bobc/RAMPS-FD/RAMPS-FD/Docs/RAMPS-FD.png

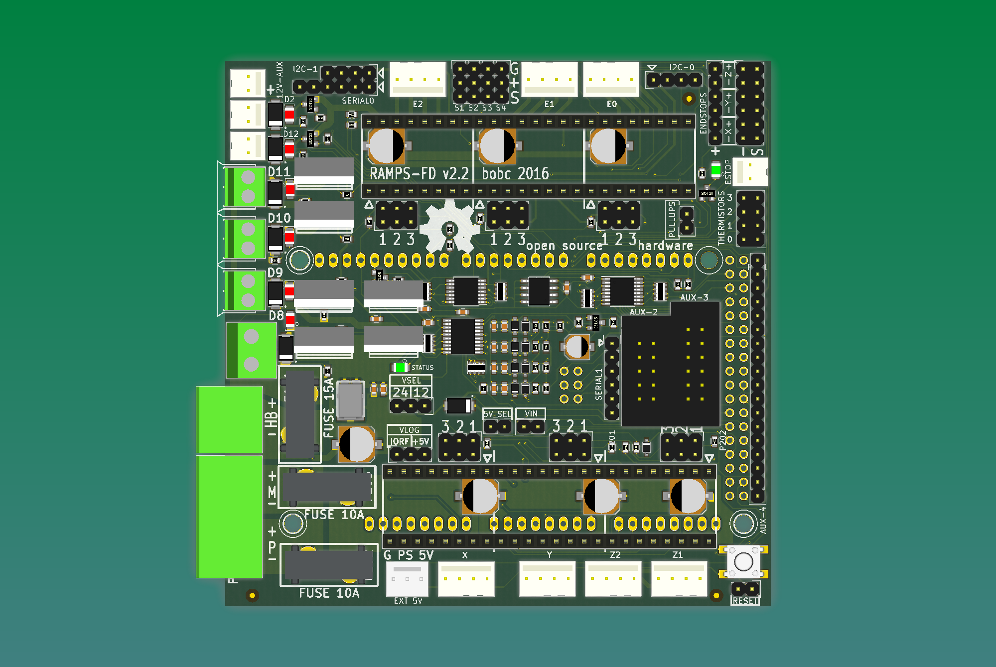
RAMPS-FD/Docs/RAMPS-FD.png
