bobc/RAMPS-FD/README.md

# RAMPS-FD

RAMPS for Due.

THIS IS THE DEVELOPMENT BRANCH.

Design files in the development branch are untested and not ready for manufacturing.

Status
-------

Nothing is ready for release yet!
