bobc/RAMPS-FD/RAMPS-FD/RAMPS-FD_bom_Itead.xlsx

Ref | Value | Footprint | Manf | MPN | Quantity | Digi-Key/Sku
C1,C2,C3,C4,C102,C207,C305,C502,C503,C504,C505,C601 | 100n | C_0603 | Kemet | C0603C104K3RACTU | 12 | 399-1281-6-ND
C101,C201,C202,C203,C204,C205,C206 | 100u; 35V | c_elec_6.3x7.7 | Nichicon | UCD1V101MCL6GS | 7 | 493-6420-1-ND
C301,C302,C303,C501 | 10u | C_0603 | Murata | GRM188R60J106ME47D | 4 | 490-3896-1-ND
C1001 | 10u | c_elec_4x5.3 | Kemet | EDK106M016A9BAA | 1 | 399-6664-1-ND
D1,D101 | LED GREEN | LED-0805_GREEN | Avago | HSMG-C170 | 2 | 516-1434-6-ND
D102 | V10P10 | TO277A_RMC | Vishay | V10P45S-M3/86A | 1 | V10P45S-M3/86A-ND
D103,D401,D402,D403,D404,D903,D904 | ES1F | DO-214AC | TaiwanSemi | ES1F | 7 | ES1FDKR-ND
D201,D202,D203,D204,D901,D902 | LED RED | LED-0805_RED | Avago | HSMH-C170 | 6 | 516-1427-1-ND
D301,D1001,D1002,D1003,D1004,D1005,D1006,D1007,D1008 | 1N4148 | SOD323 | Fairchild | 1N4148WS | 9 | 1N4148WSFSCT-ND
F101,F102,F103 |  | FUSE-MINI-AUTO | LittelFuse | 01530008Z | 3 | F065-ND
JP1,JP201,JP801,P102 |  | Pin_Header_Straight_1x02 | AmphenolFCI | 68001-402HLF | 4 | 609-3507-ND
JP101,JP102,K201,K202,K203,K204 |  | Pin_Header_Straight_1x03 | AmphenolFCI | 68001-403HLF | 6 | 609-3471-ND
L1 | Ferrite Bead | R_0603 | TDK | MMZ1608B601CTAH0 | 1 | 445-2166-1-ND
P1,P216,P801 |  | Pin_Header_Straight_1x06 | AmphenolFCI | 68001-406HLF | 3 | 609-3284-ND
P2,P211 |  | Pin_Header_Straight_1x04 | AmphenolFCI | 68001-404HLF | 2 | 609-3404-ND
P3,P204,P205,P206,P210,P212,P217 |  | CONN_KK_2.54_4W | Molex | 0022232041 | 7 | WM4202-ND
P101 |  | mstba_2,5%2f2-g-5,08 | AmphenolFCI | 20020110-H021A01LF | 1 | 609-3907-ND
P105,P302,P901,P902 |  | CONN_KK_2.54_2W | Molex | 0022232021 | 4 | WM4200-ND
P108 |  | mstba_2,5%2f4-g-5,08 | AmphenolFCI | 20020110-H041A01LF | 1 | 609-3909-ND
P201,P202,P203,P207,P208,P209 |  | Pin_Header_Straight_2x03 | AmphenolFCI | 67996-406HLF | 6 | 609-3218-ND
P213 |  | Pin_Header_Straight_1x18 | Sullins | PREC018SAAN-RC | 1 | S1012EC-18-ND
P214 |  | PIN_ARRAY_5x2_RMC | AmphenolFCI | 67996-410HLF | 1 | 609-3392-ND
P215,P802 |  | PIN_ARRAY_6x2_RMC | AmphenolFCI | 67996-412HLF | 2 | 609-3219-ND
P218,P403,P405 |  | RMC-pt_1,5-2-3,5-h | AmphenolFCI | 20020110-C021A01LF | 3 | 20020110-C021A01LF-ND
P219 |  | CONN_KK_2.54_3W | Molex | 0022232031 | 1 | WM4201-ND
P301 |  | Pin_Header_Straight_2x04 | AmphenolFCI | 67996-408HLF | 1 | 609-3391-ND
P404 |  | mors_2p | PhoenixContact | 1711725 | 1 | 277-1027-ND
Q1,Q101,Q901,Q902 | DMN2075 | SOT23GDS | DiodesZetex | DMN2075U-7 | 4 | DMN2075U-7DIDKR-ND
Q201,Q202,Q203,Q206 | IRLB8743PBF | TO-220AB_IRF2804_RMC | Infineon | IRLB8743PBF | 4 | IRLB8743PBF-ND
R1,R2,R211,R212 | NF | R_0603 |  |  | 4
R3,R101 | 330R | R_0603 | Vishay | CRCW0603330RFKEA | 2 | 541-330HDKR-ND
R201,R202,R203,R207,R208,R210,R304 | 100k | R_0603 | Vishay | CRCW0603100KFKEA | 7 | 541-100KHDKR-ND
R219,R220,R221,R222,R301,R302,R303,R501,R905,R906,R1004 | 1k | R_0603 | Vishay | CRCW06031K00FKEA | 11 | 541-1.00KHDKR-ND
R305,R502,R503,R504,R505 | 4k7 | R_0603 | Vishay | CRCW06034K70FKEA | 5 | 541-4.70KHCT-ND
R401,R402 | 10k | R_0603 | Vishay | CRCW060310K0FKEA | 2 | 541-10.0KHDKR-ND
R701,R702,R703,R704,R901,R902 | 220R | R_0603 | Vishay | CRCW0603220RFKEA | 6 | 541-220HDKR-ND
R1002 | 6k8 | R_0603 | Vishay | CRCW06036K80FKEA | 1 | 541-6.80KHCT-ND
R1003 | 1k8 | R_0603 | Vishay | CRCW06031K80FKEA | 1 | 541-1.80KHCT-ND
RP1,RP2,RP3,RP401,RP801,RP802 | 10k | R_Cat16-4 | Bourns | CAT16-103J4LF | 6 | CAT16-103J4LFCT-ND
 |  |  |  |  | 1
SW101 | Switch | SW_6x6_MULTI | Wurth | 430156070726 | 1 | 430156070726-ND
U1 | 74ACT125 | TSSOP-14_4.4x5mm_Pitch0.65mm | ONSemi | MC74HCT125ADTR2G | 1 | MC74HCT125ADTR2GOSCT-ND
U2 | 74ACT244 | TSSOP-20_4.4x6.5mm_Pitch0.65mm | NXP | 74HCT244PW,112 | 1 | 568-7845-5-ND
U3 | LM7812 | LM78XXV | Fairchild | LM7812ACT | 1 | LM7812ACT-ND
U4 | L7805CV-DG | LM78XXV | STMicro | L7805CV-DG | 1 | 497-12404-ND
U201,U202,U203,U204,U205,U206 |  | POLOLU | Sullins | PPTC081LFBN-RC | 12 | S7006-ND
U601 | 24C512 | SO8E | STMicro | M24512-RMN6TP | 1 | 497-6350-6-ND
U801 | 4050_RMC | TSSOP-16_4.4x5mm_Pitch0.65mm | NXP | 74HC4050PW,118 | 1 | 568-7640-1-ND
U1001 | TL431_SOT23_RMC | SOT23 | STMicro | TL431AIL3T | 1 | 497-11295-6-ND
