bobc/RAMPS-FD/(threads)

Thread 1 (2017-02-03):

LM7812 gets very hot

fullTalgoRythm, 2017-02-03:
When running @24v with JP102 -VSEL pins 1-2 selected I found that the 7812 is getting very hot. I could actually smell it even with a fan running. I believe this would be a fairly typical problem when trying to drop 12v over a linear regulator like this one. I know there are a number of workarounds and personally I replaced mine with a cheap buck converter (LM2596). I can see it is still spec'd so I thought maybe you could investigate some alternatives. Myself I wouldn't mind a separate  input for board power / hotend & fans and then just supply my own power (I did briefly feed 12v in via pin 2 of JP102 but it was a messy solution). It's probably not what most others would want but would make a nice option.

fullTalgoRythm, 2017-02-03:
Looks like the Ramps fd issues are all being posted against bobc_hardware so i will close this and open there instead

Closed 2017-02-03.

Thread 2 (2018-03-04):

Stepper outputs are too tight nearby

dembach, 2018-03-04:
Hi Bob,

if you want to use the JST XH connectors , which is the standard for Steppers , it is too tight.

JST XH 4 pin is about 12.4 mm width.
So Y, Z1 , Z2 should be spreaded more in the direction towards X. Best would be if all these connectors ( Ext5VPS , X , Y , Z2 and Z1 ) have the same distance to each other.

also the space in between E0 and E1 stepper connector has to be a little bit wider....

thanks
 Markus

boelle, 2018-07-05:
molex KK are better as they prevent the connector slipping of

dembach, 2018-07-08:
@boelle : JST XH do also prevent slipping off... they are often used in RC-Planes also...  proven safety.

Molex KK are the power connectors for old 3.5'' floppy ... YEAH.. works also...

both connectors are mainly used as connector for Stepper cables.... so it should be compatible to both ..

Thread 4 (2018-09-03):

Quick Q... tmc2130

boelle, 2018-09-03:
So i'm studing the schematics hard and one thing i did not make not of before that there is support for tmc2130 on the the steppers but not on the extruders

did you not get that far or did it not make sense to add it there?

and i might be wrong but are there not also support for tmc2208 except the extruders?

i ask because rather than modding the board i will make a small and narrow add-on board that makes the connections, for me it would be a bit silly to mod the board if its only missing support on half the steppers

and lastly... do you accept PR's to this repro or would you rather i fork it and make the changes there?

Thread 5 (2018-09-04):

Testing

boelle, 2018-09-04:
Got the board layout approved from fabhouse in china

Are there any way and order you recommend assembling and testing in?

my idea would be to take the schematic more or less in order and test each section as i go

ie front page first and each sub schematic starting top left and then the top right before going down
