bobc/RAMPS-FD/RAMPS-FD/Docs/RAMPS-FD.pdf

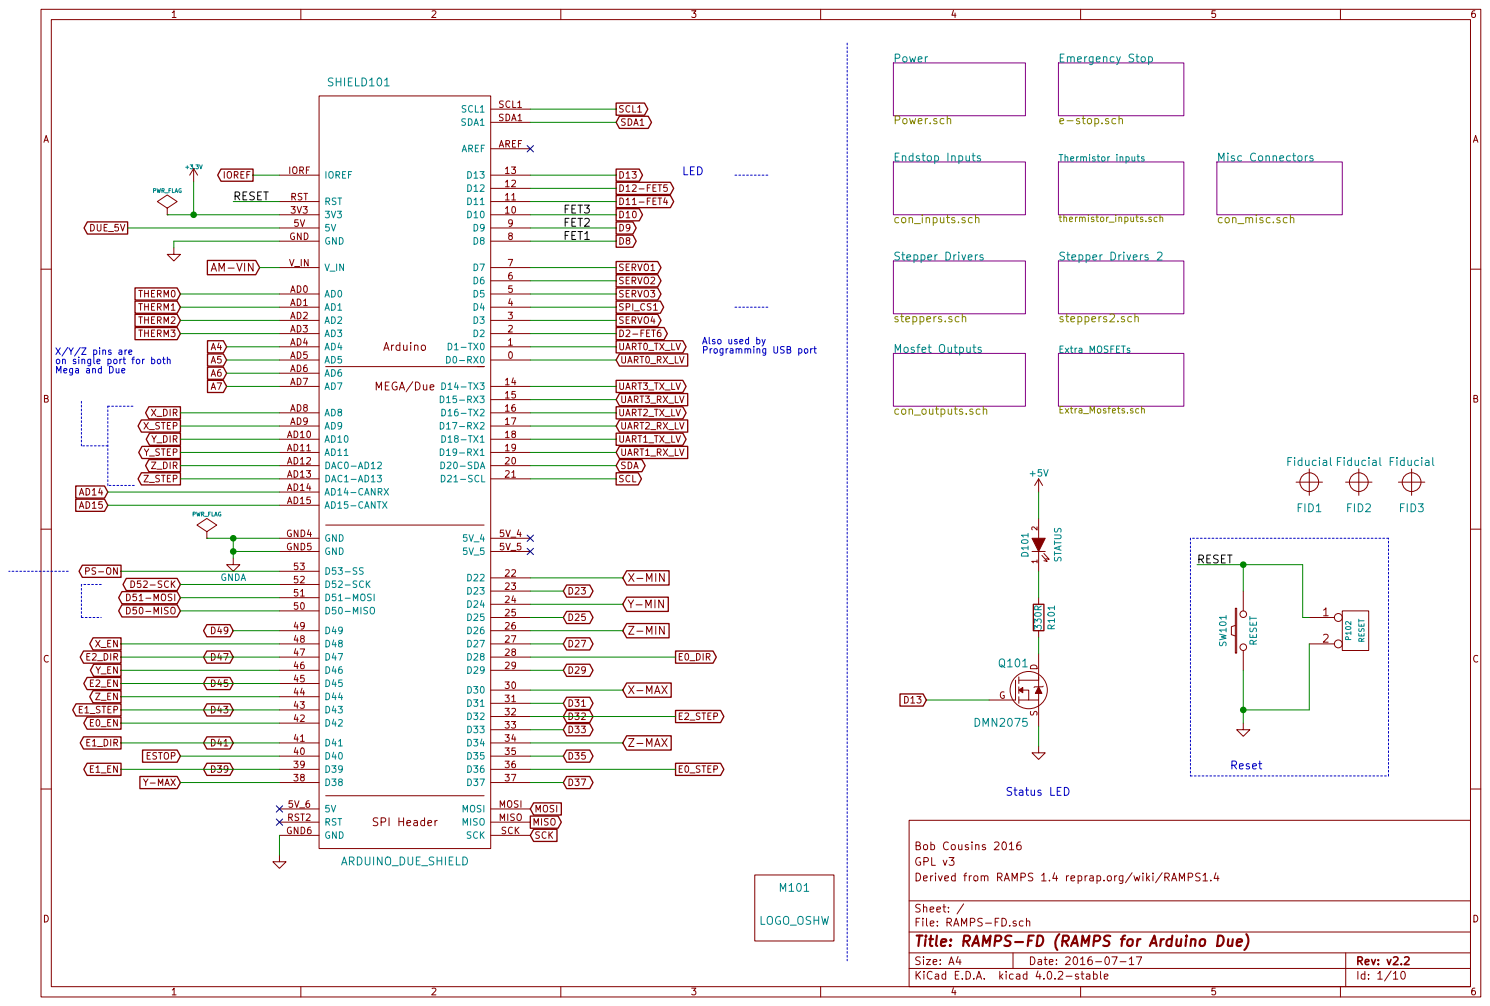
[picture p2: page 1]

X/Y/Z pins are
on single port for both

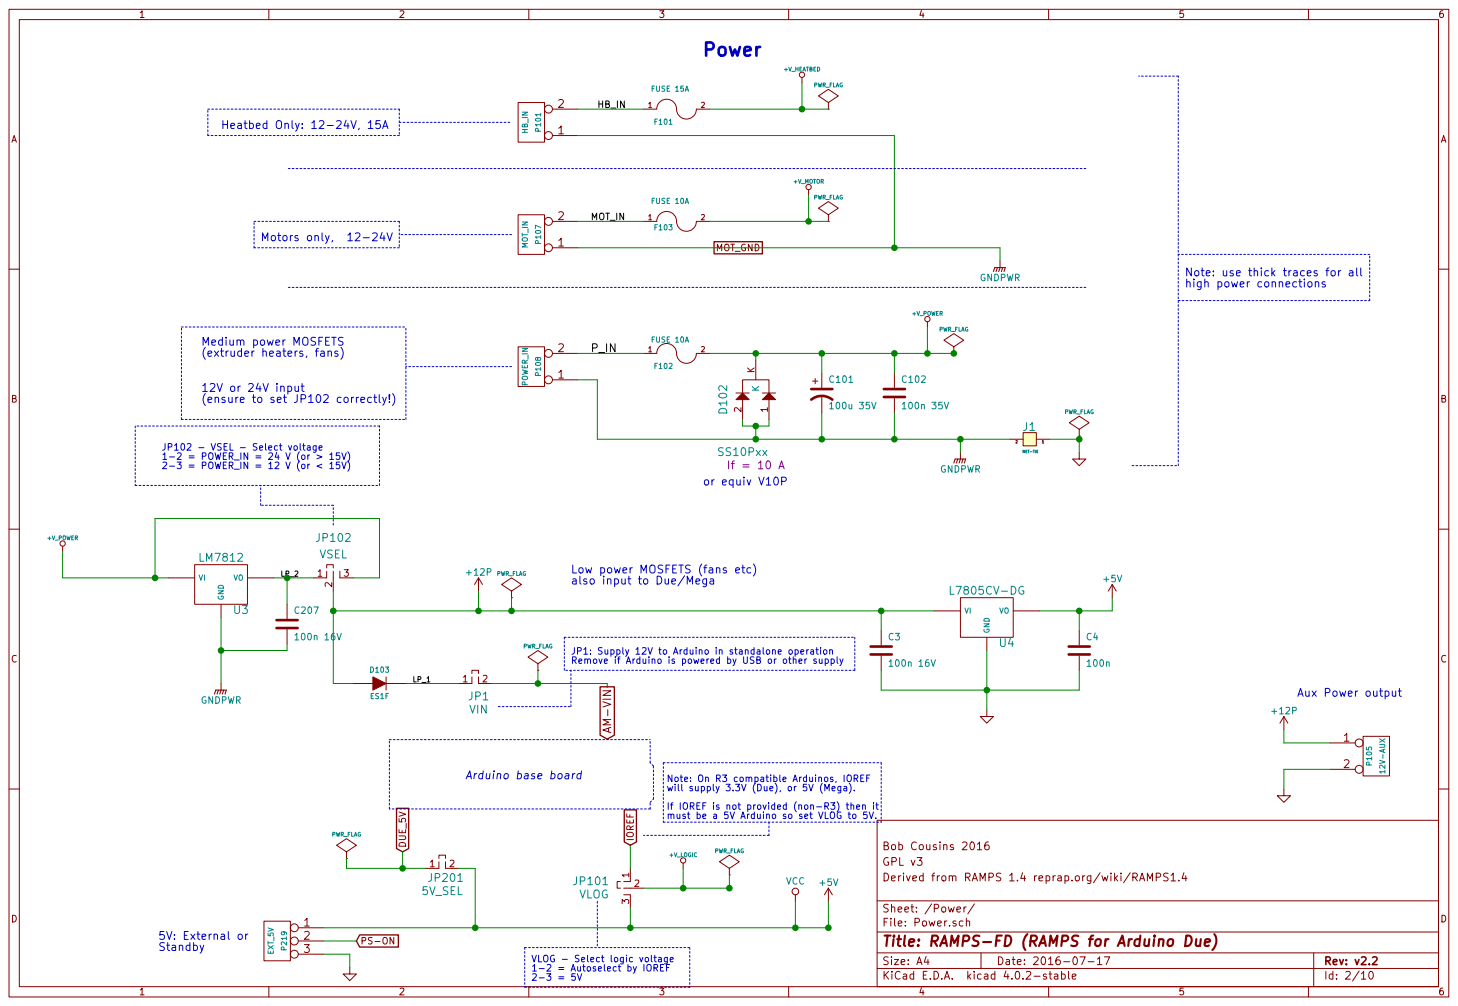
[picture p3: page 2]

PWR_FLAG PS-ON Medium power MOSFETS
(extruder heaters, fans)

also input to Due/Mega IOREF

Low power MOSFETS (fans etc)

Remove if Arduino is powered by USB or other supply C207

Aux Power output AM-VIN

will supply 3.3V (Due), or 5V (Mega).
If IOREF is not provided (non-R3) then it must be a 5V Arduino so set VLOG to 5V.

Id: 2/10 Title: RAMPS-FD (RAMPS for Arduino Due) File: Power.sch Sheet: /Power/ Derived from RAMPS 1.4 reprap.org/wiki/RAMPS1.4 GPL v3 Bob Cousins 2016

VLOG - Select logic voltage
1-2 = Autoselect by IOREF

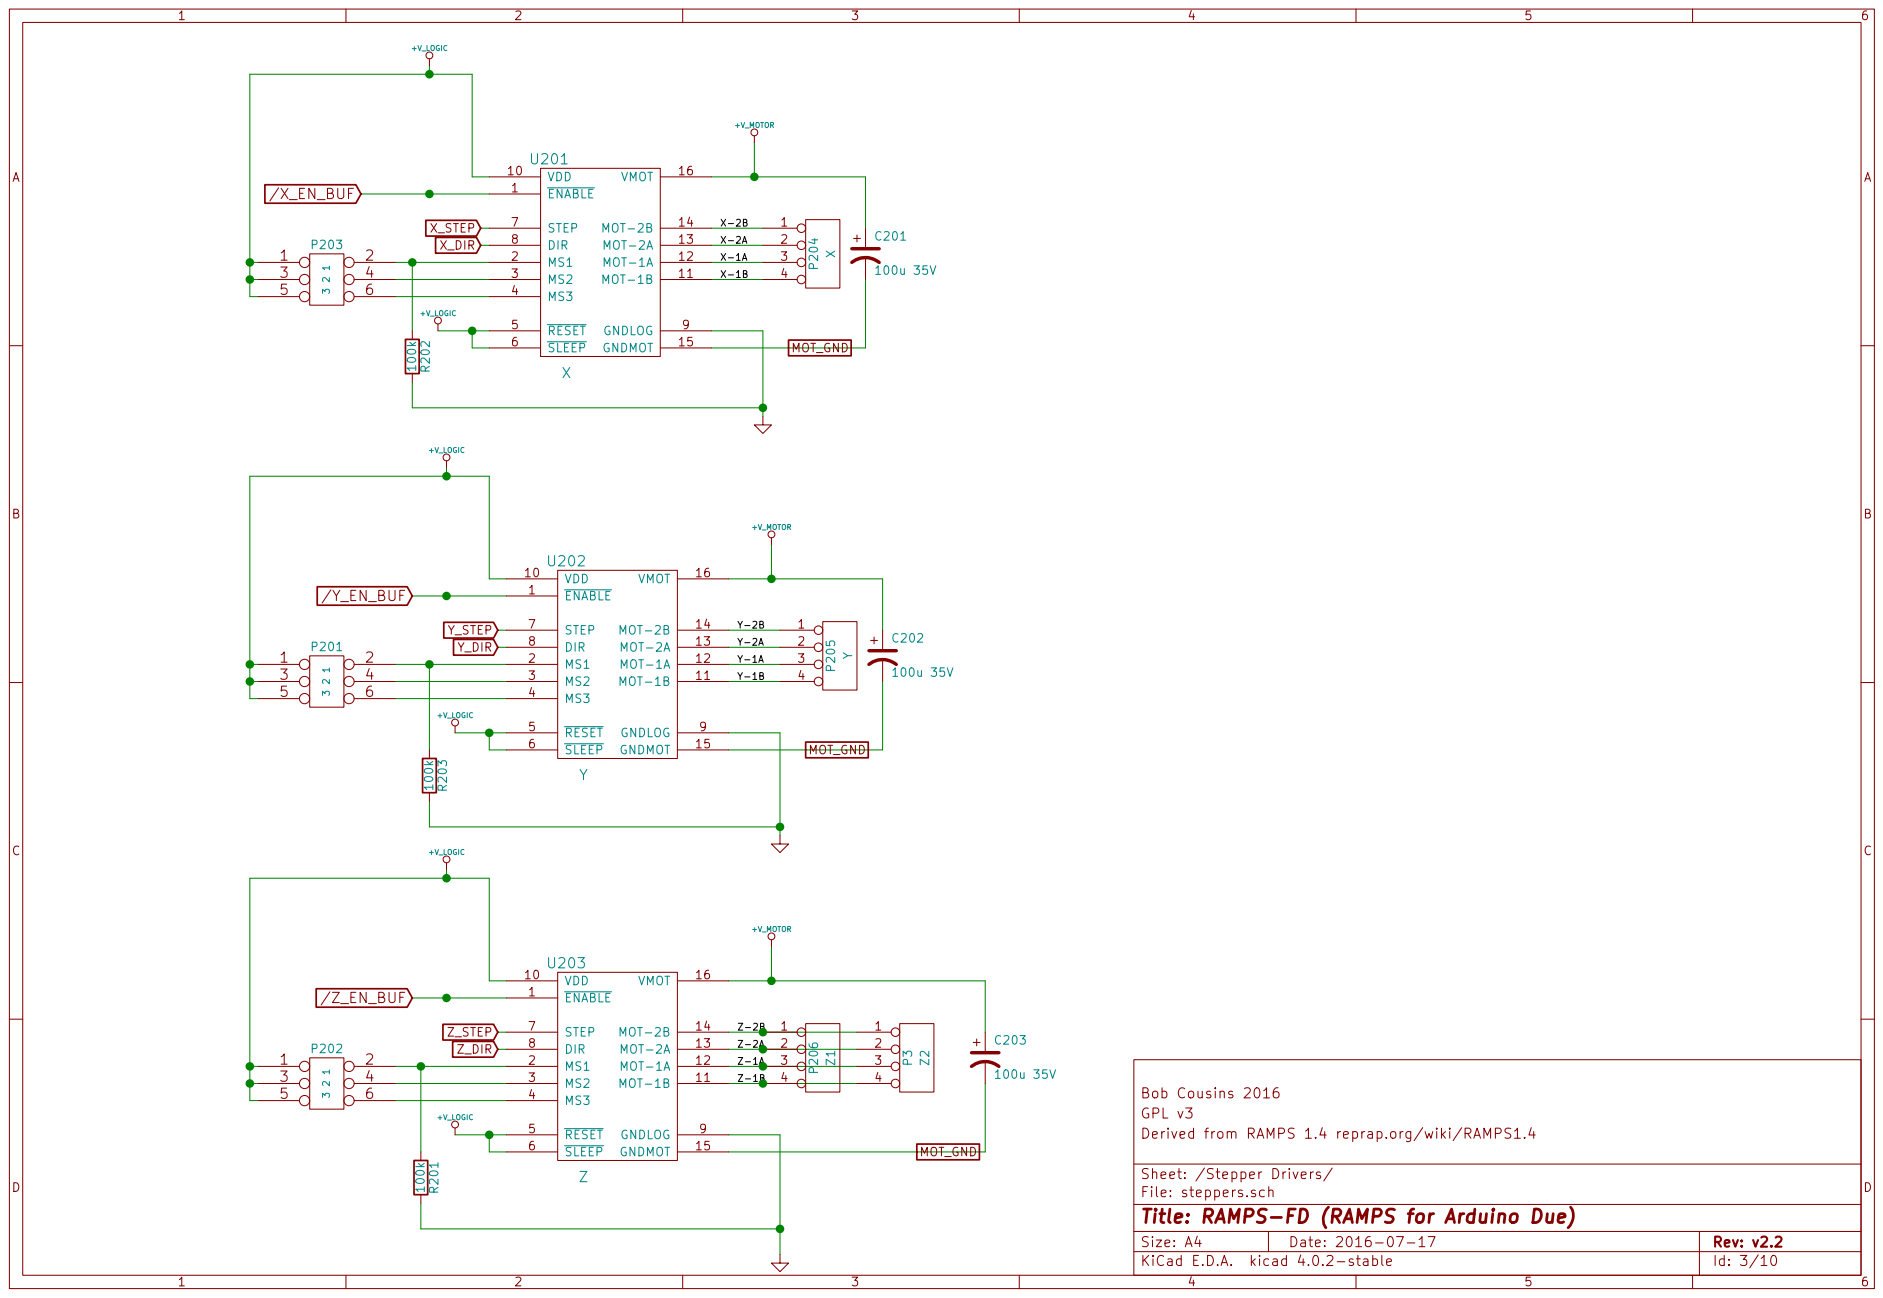
[picture p4: page 3]

Derived from RAMPS 1.4 reprap.org/wiki/RAMPS1.4 GPL v3 Bob Cousins 2016

Sheet: /Stepper Drivers/
File: steppers.sch
Id: 3/10 Title: RAMPS-FD (RAMPS for Arduino Due)

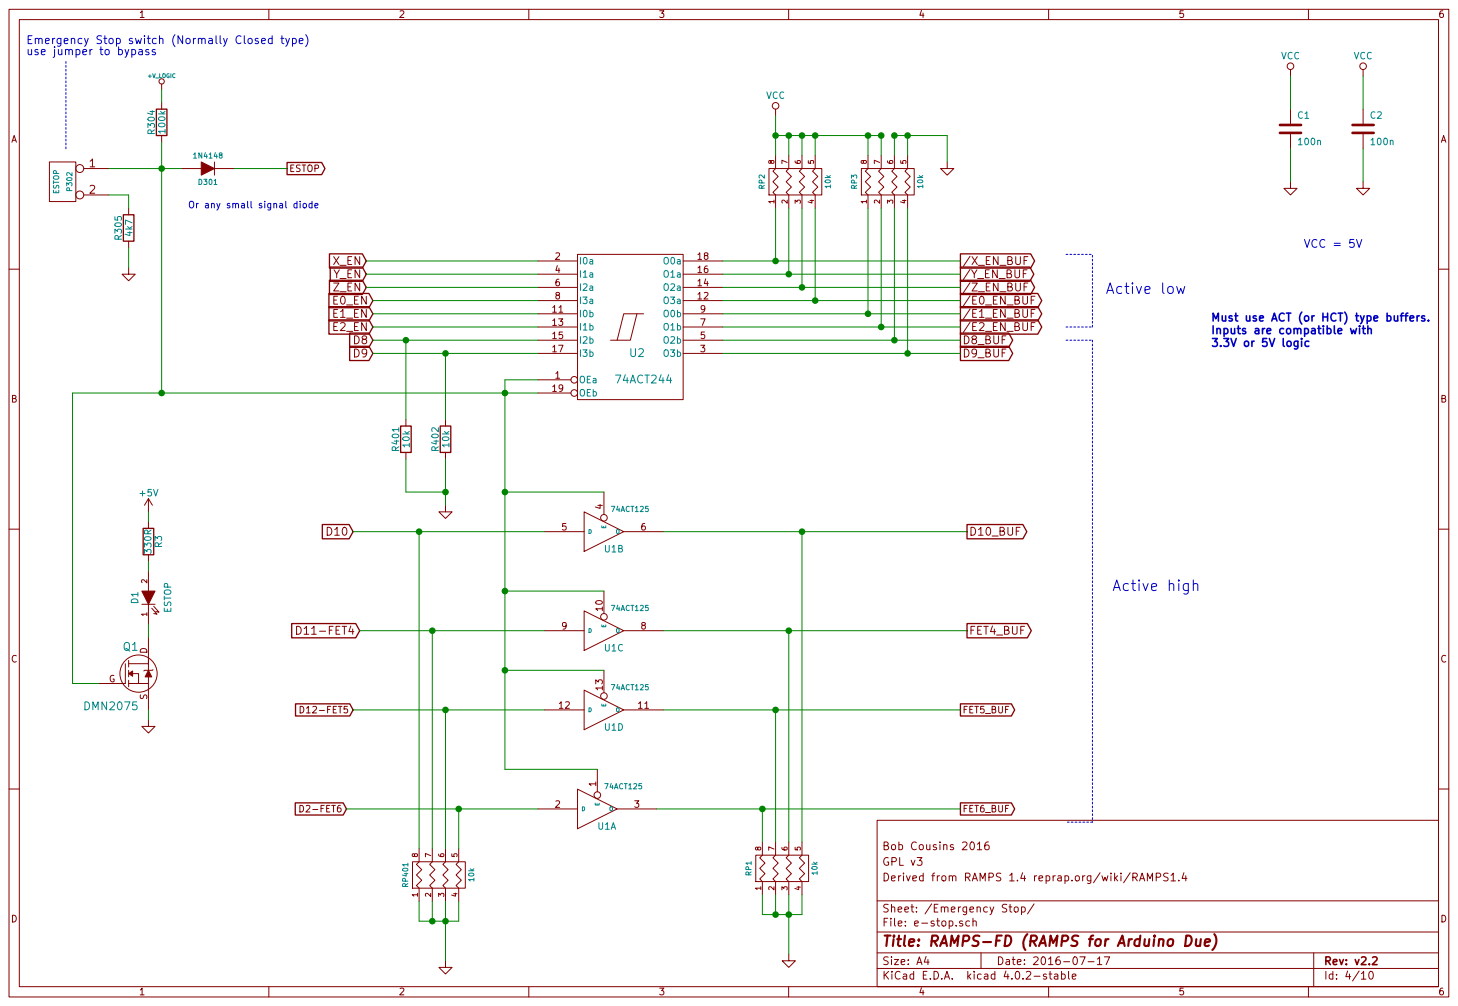
[picture p5: page 4]

Emergency Stop switch (Normally Closed type)
use jumper to bypass

Must use ACT (or HCT) type buffers.
Inputs are compatible with
3.3V or 5V logic

Derived from RAMPS 1.4 reprap.org/wiki/RAMPS1.4 GPL v3 Bob Cousins 2016

Sheet: /Emergency Stop/
File: e-stop.sch
Id: 4/10 Title: RAMPS-FD (RAMPS for Arduino Due)

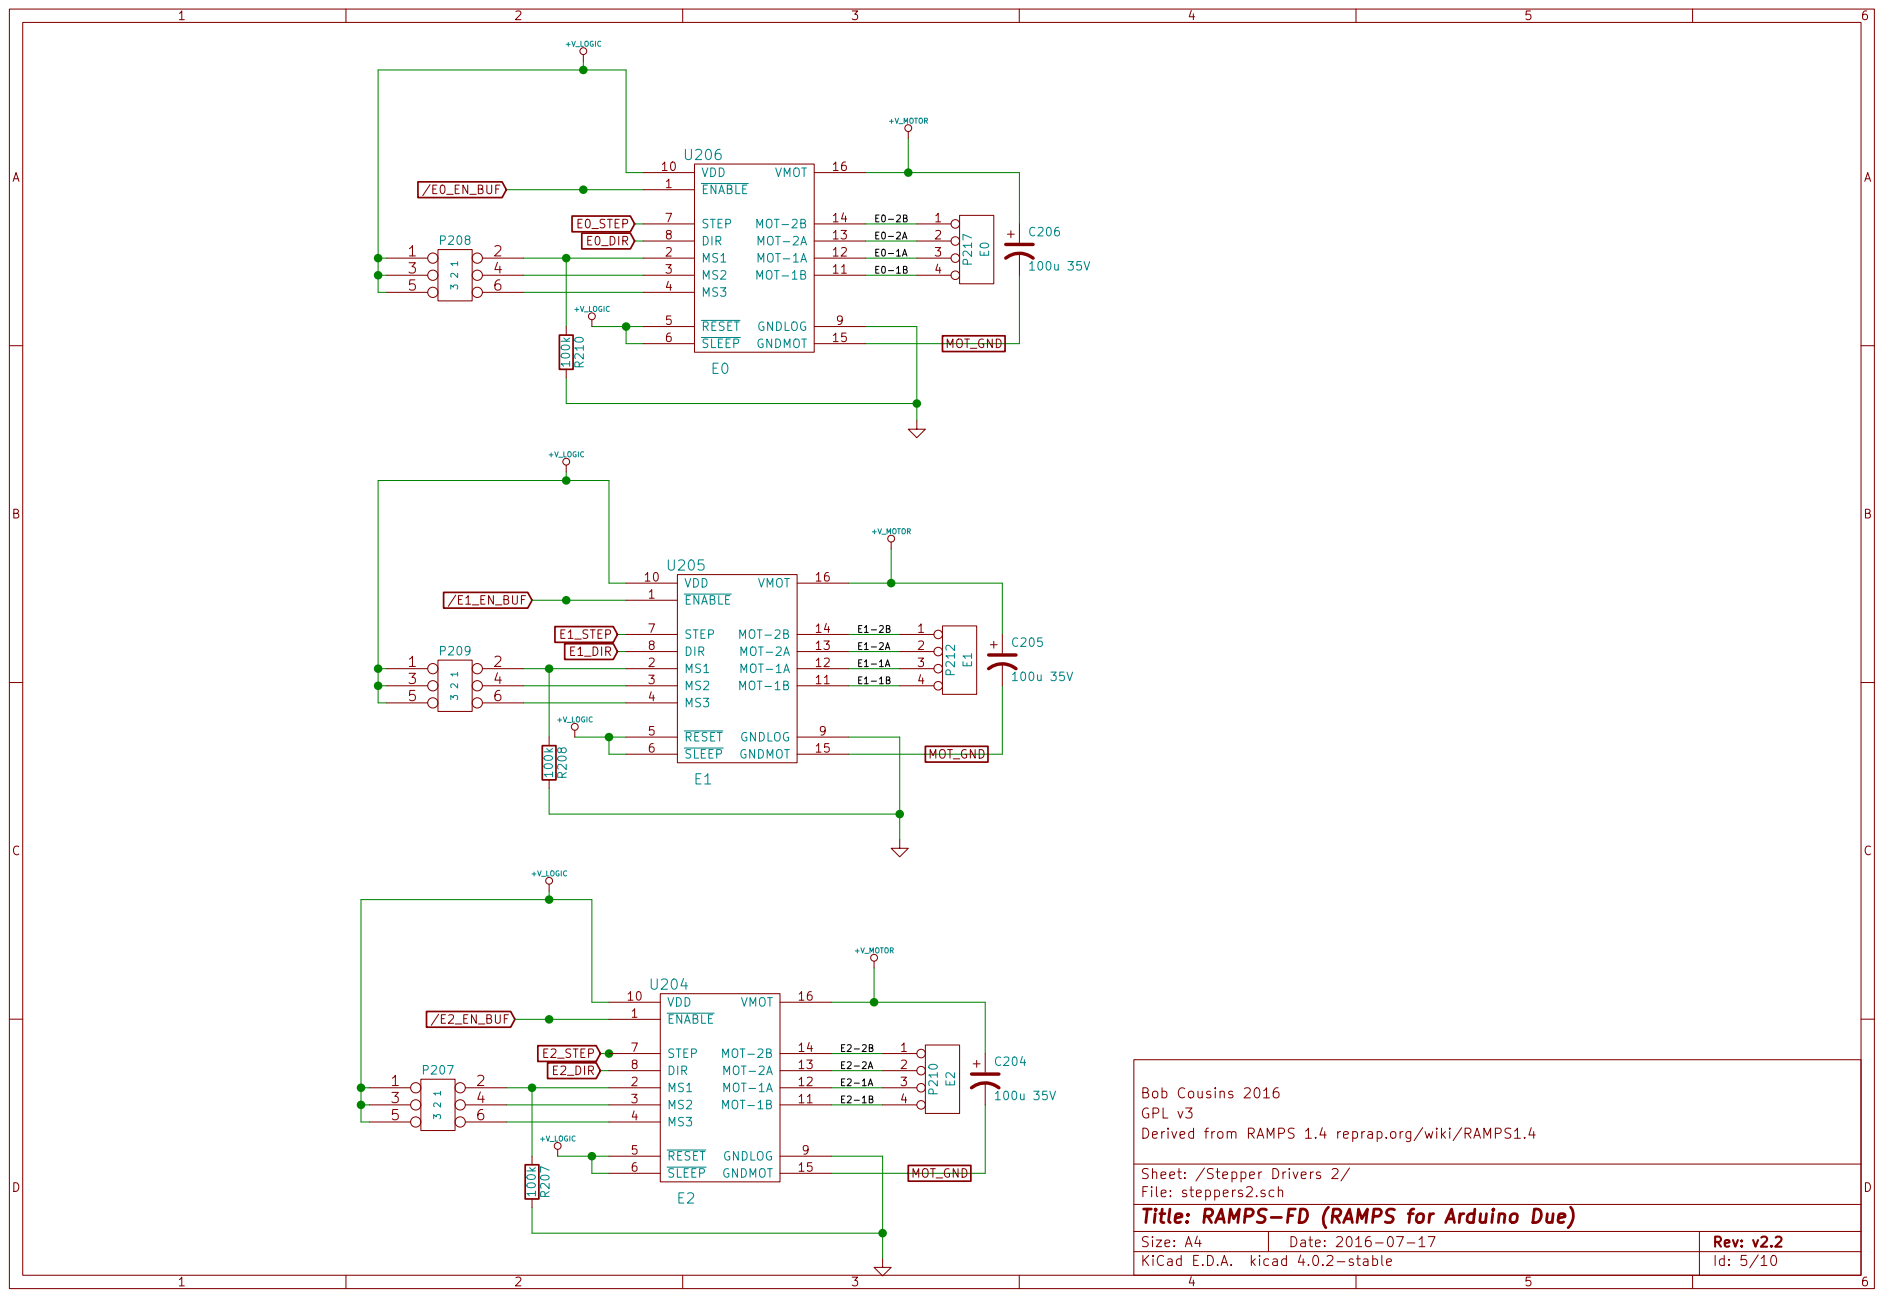
[picture p6: page 5]

Derived from RAMPS 1.4 reprap.org/wiki/RAMPS1.4 GPL v3 Bob Cousins 2016

Sheet: /Stepper Drivers 2/
File: steppers2.sch
Id: 5/10 Title: RAMPS-FD (RAMPS for Arduino Due)

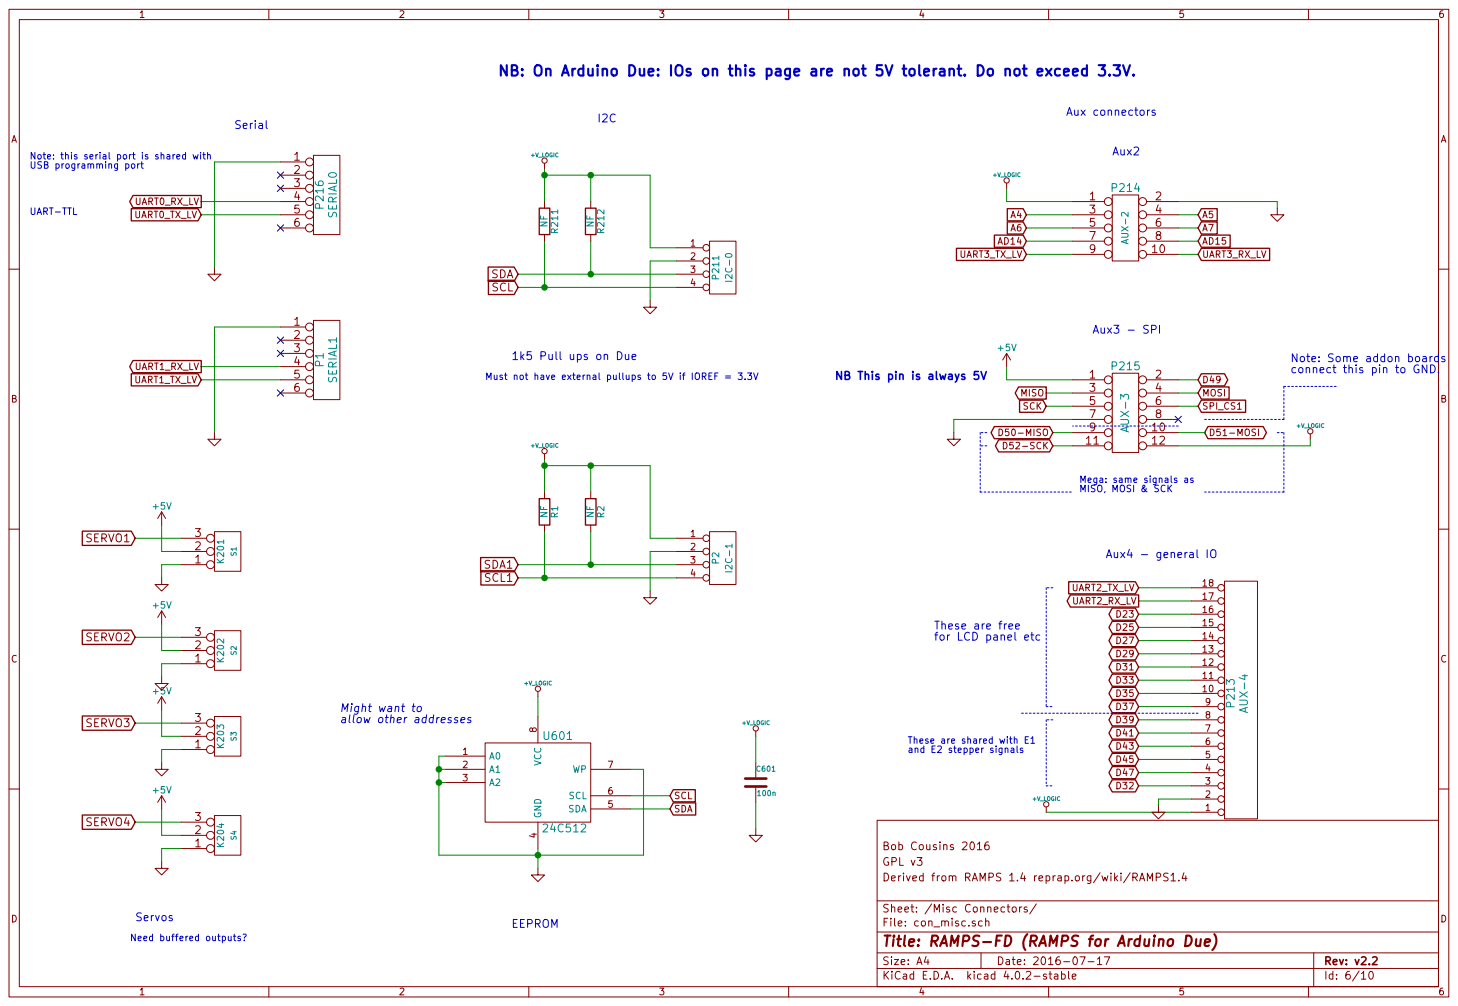
[picture p7: page 6]

NB: On Arduino Due: IOs on this page are not 5V tolerant. Do not exceed 3.3V.

Note: this serial port is shared with

+5V NB This pin is always 5V
Mega: same signals as MISO, MOSI & SCK D32

connect this pin to GND. GND

+V_LOGIC Might want to allow other addresses

These are shared with E1 and E2 stepper signals

File: con_misc.sch Sheet: /Misc Connectors/ Derived from RAMPS 1.4 reprap.org/wiki/RAMPS1.4 GPL v3 Bob Cousins 2016

Id: 6/10 Title: RAMPS-FD (RAMPS for Arduino Due)

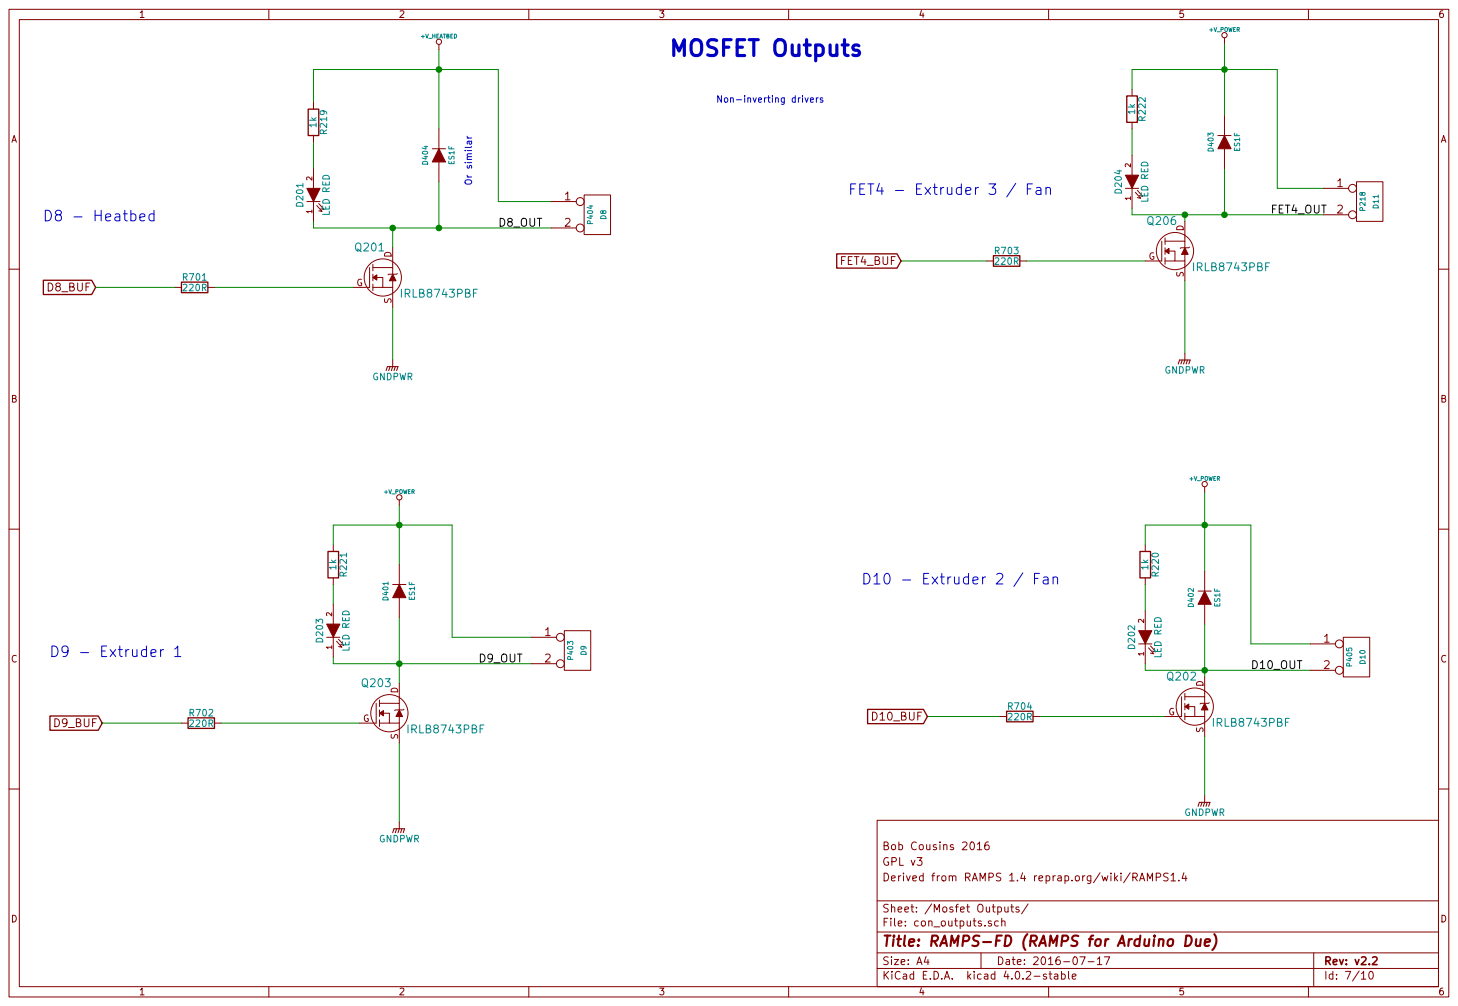
[picture p8: page 7]

Derived from RAMPS 1.4 reprap.org/wiki/RAMPS1.4 GPL v3 Bob Cousins 2016

Sheet: /Mosfet Outputs/
File: con_outputs.sch
Id: 7/10 Title: RAMPS-FD (RAMPS for Arduino Due)

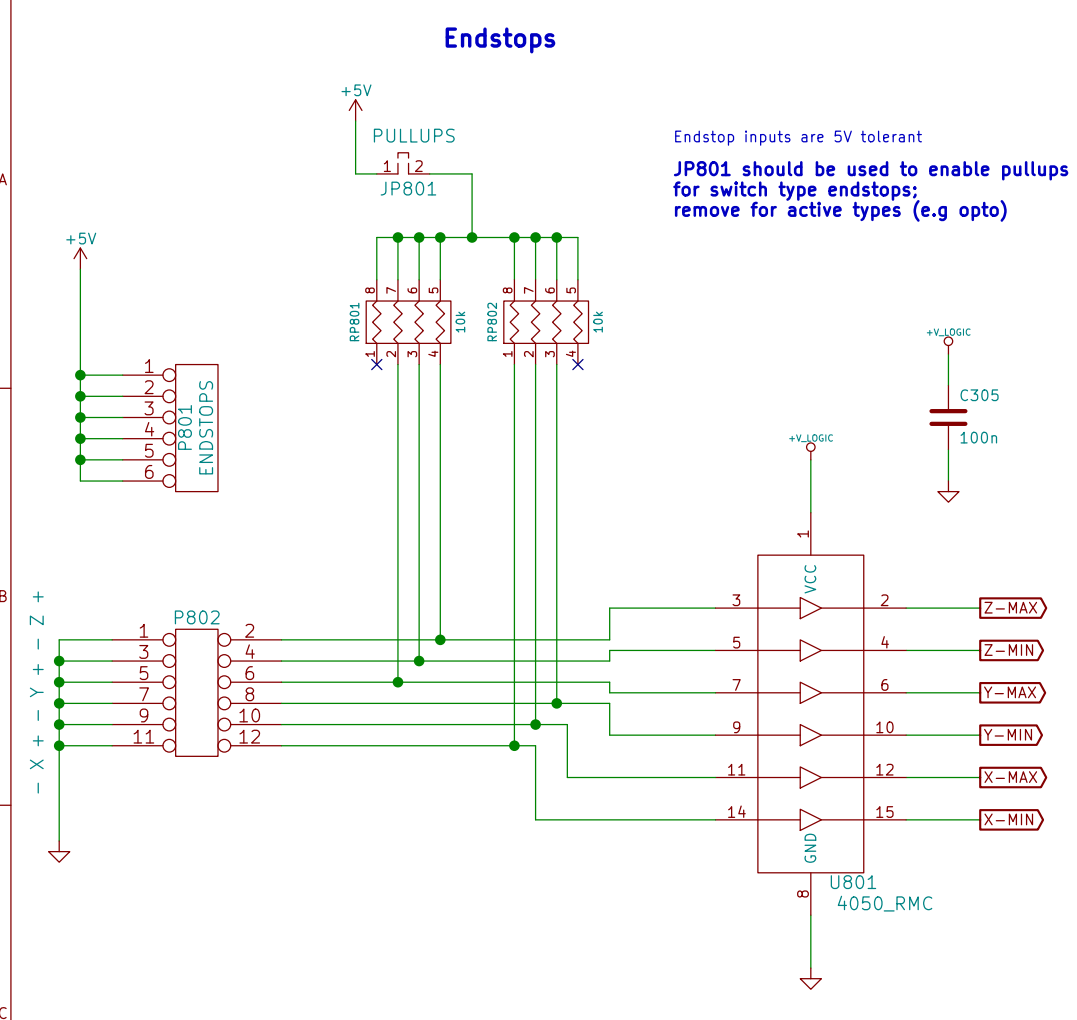
[picture p9: page 8]

Endstop inputs are 5V tolerant
JP801 should be used to enable pullups
for switch type endstops;
remove for active types (e.g opto)

Derived from RAMPS 1.4 reprap.org/wiki/RAMPS1.4 GPL v3 Bob Cousins 2016

Sheet: /Endstop Inputs/
File: con_inputs.sch
Id: 8/10 Title: RAMPS-FD (RAMPS for Arduino Due)

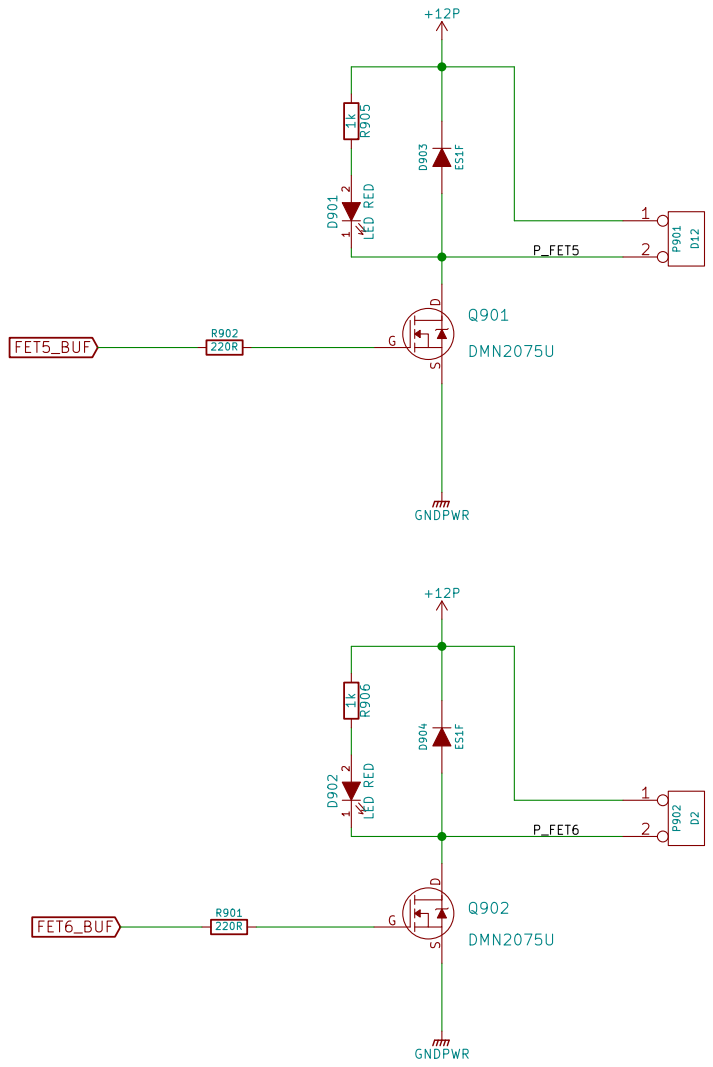
[picture p10: page 9]

File: Extra_Mosfets.sch Sheet: /Extra MOSFETs/ Derived from RAMPS 1.4 reprap.org/wiki/RAMPS1.4 GPL v3 Bob Cousins 2016

Id: 9/10 Title: RAMPS-FD (RAMPS for Arduino Due)

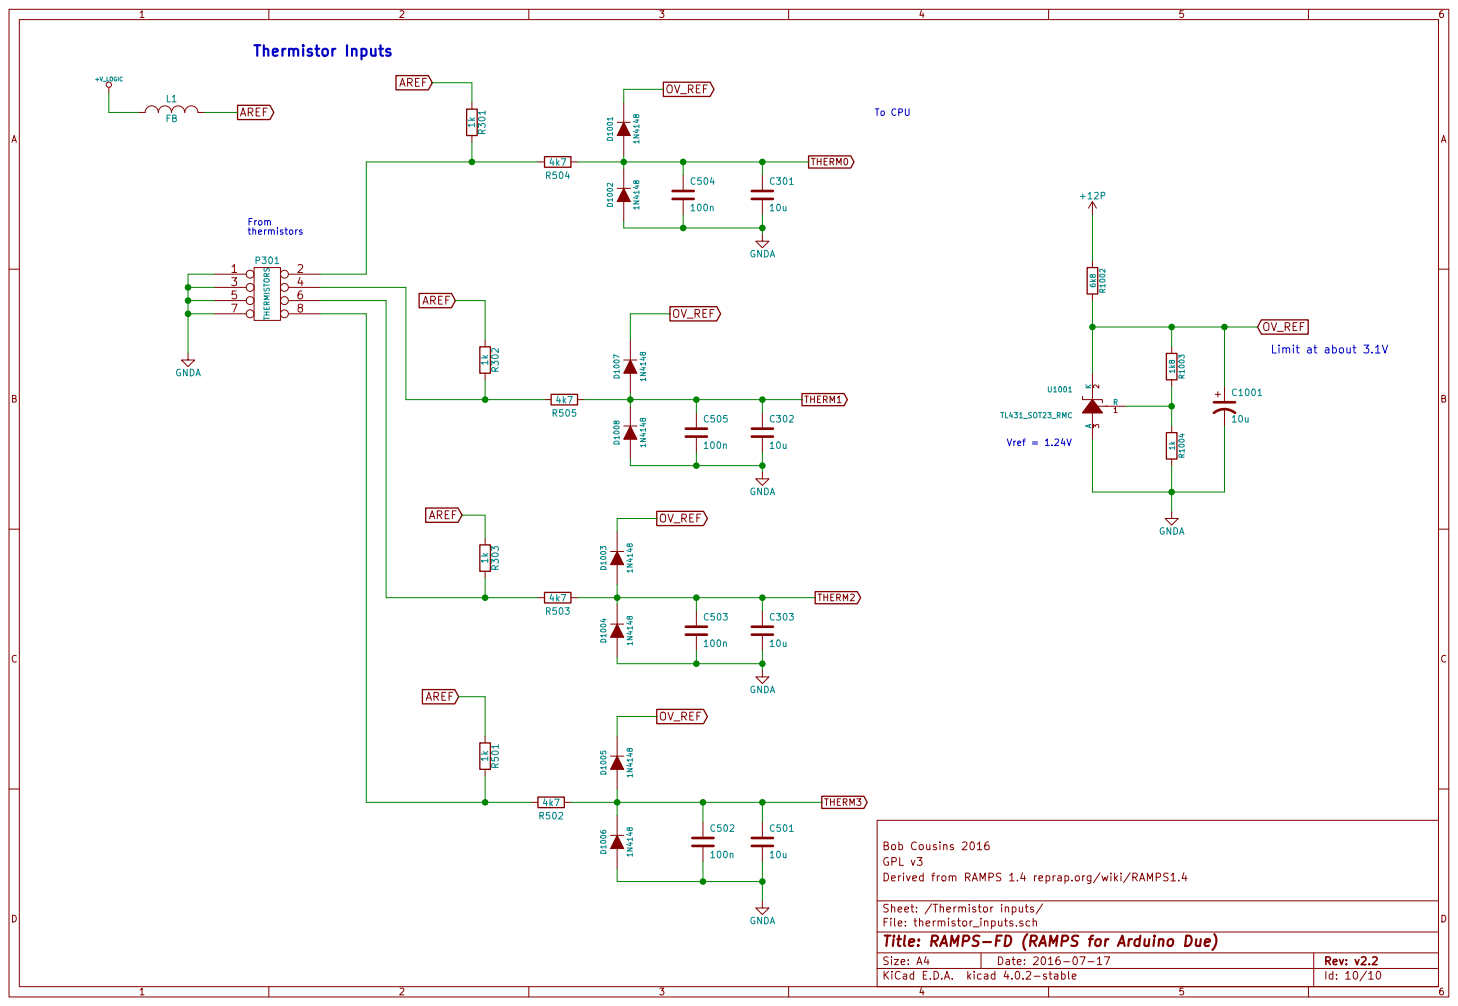
[picture p11: page 10]

Derived from RAMPS 1.4 reprap.org/wiki/RAMPS1.4 GPL v3 Bob Cousins 2016

Sheet: /Thermistor inputs/
File: thermistor_inputs.sch
Id: 10/10 Title: RAMPS-FD (RAMPS for Arduino Due)
