bobc/RAMPS-FD/RAMPS-FD/RAMPS-FD.kicad_pcb

## KiCad design RAMPS-FD/RAMPS-FD.kicad_pcb (2018-06-02)

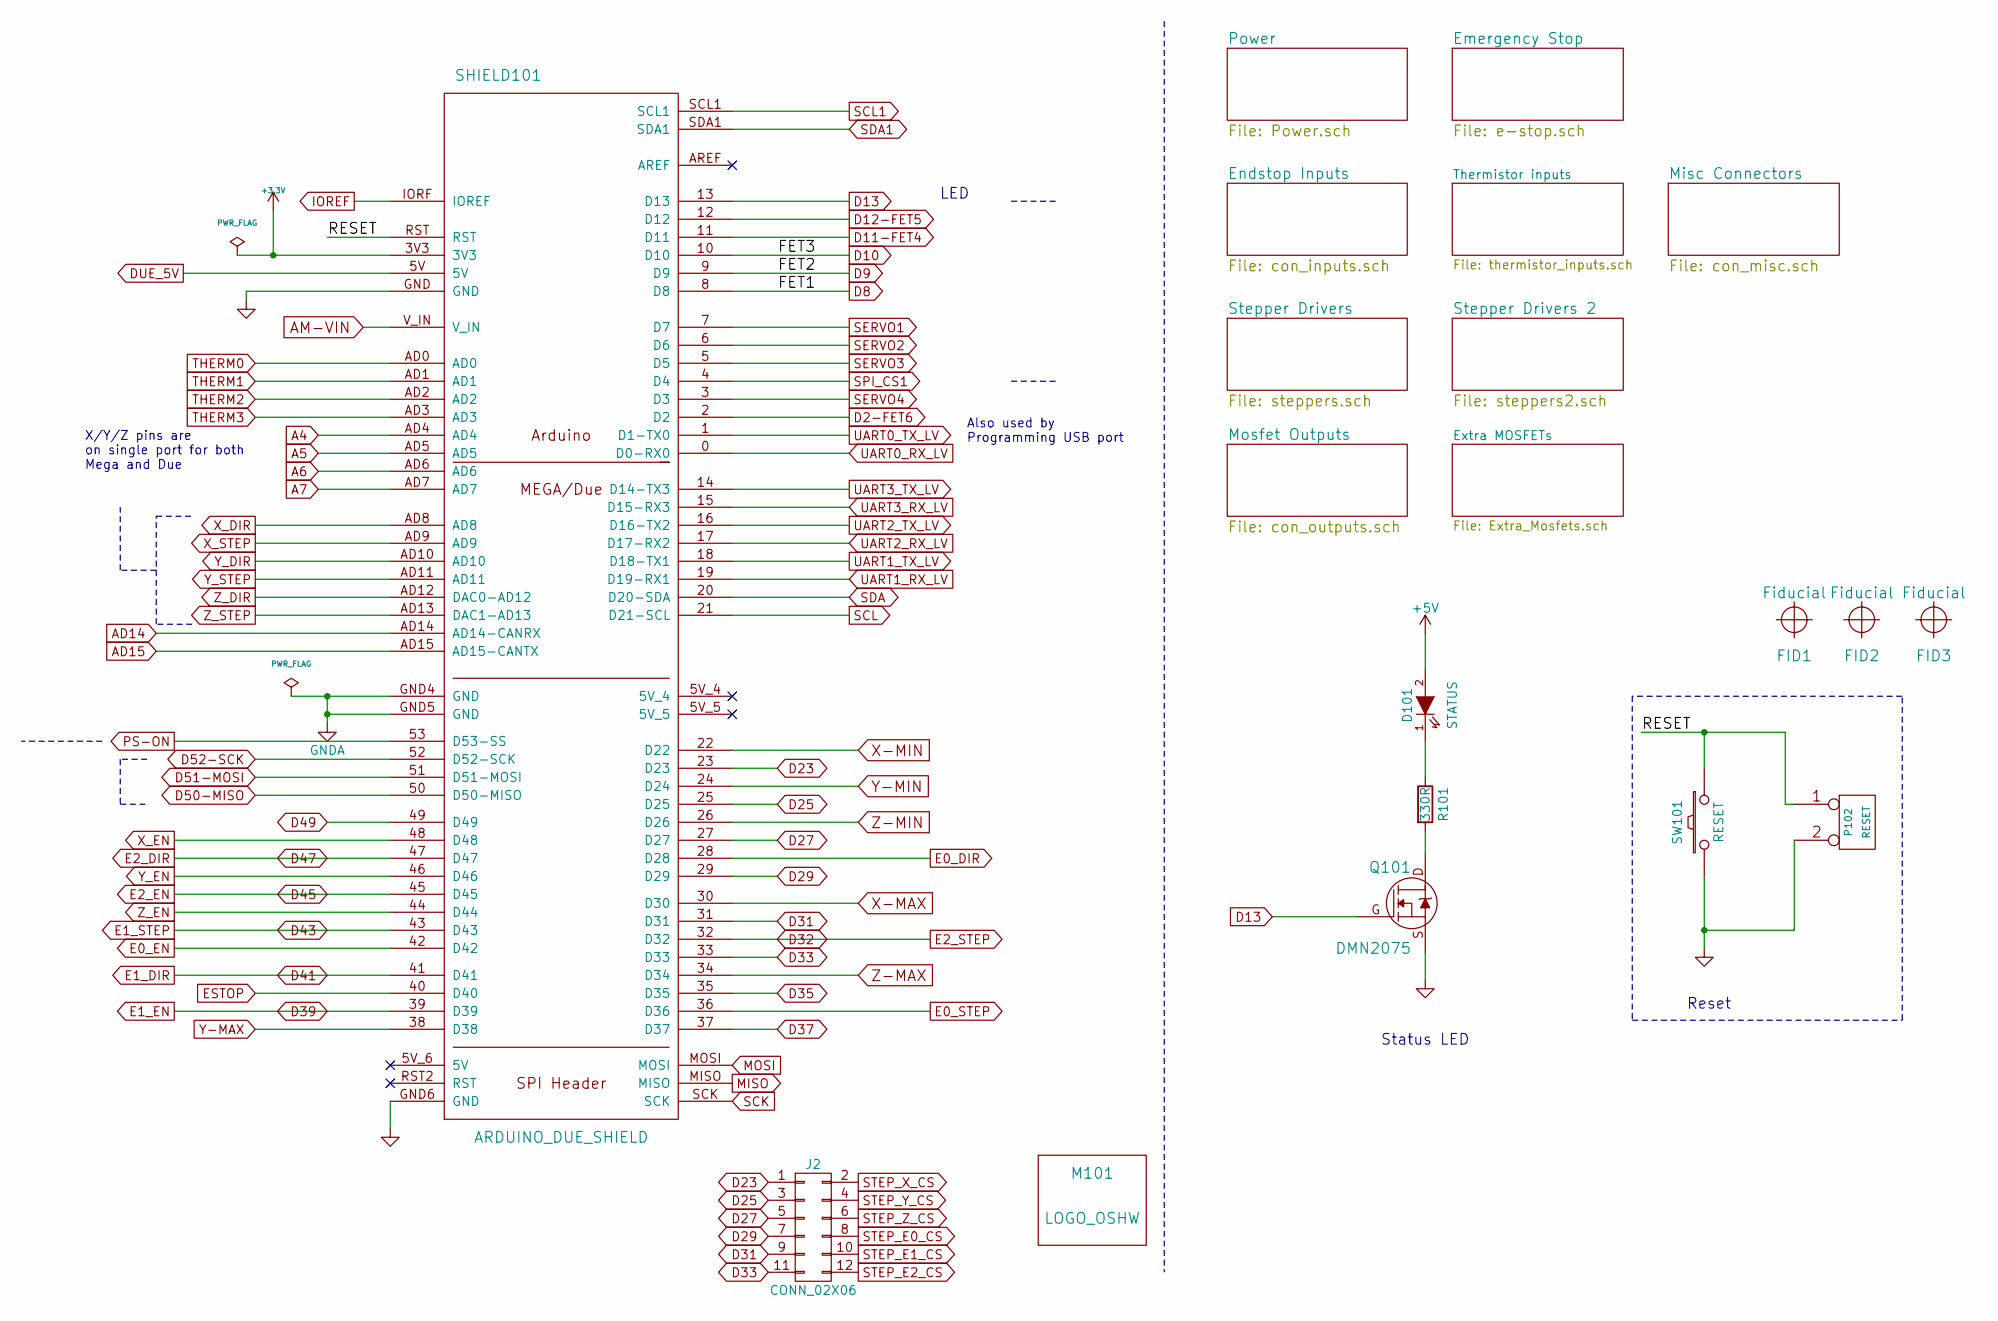
[picture p12: schematic RAMPS-FD.sch, RAMPS-FD (RAMPS for Arduino Due)]

Parts:
D101: STATUS; LED-0805_GREEN
FID1, FID2, FID3: Fiducial; Fiducial_1mm_Dia_2.54mm_Outer_CopperTop
J2: CONN_02X06; Pin_Header_Straight_2x06_Pitch2.54mm
M101: LOGO_OSHW; OSHW_logo_2
P102: RESET; Pin_Header_Straight_1x02_Pitch2.54mm
Q101: DMN2075; SOT23GDS
R101: 330R; R_0603
SHIELD101: ARDUINO_DUE_SHIELD; ARDUINO_MEGA_DUE_SHIELD_FOOTPRINT_RMC
SW101: RESET; SW_6x6_SMD

Connections:
+5V: D101.2 (A); also elsewhere on the board
/RESET: P102.1, SHIELD101.RST, SW101.1
A4: SHIELD101.AD4; also elsewhere on the board
A5: SHIELD101.AD5; also elsewhere on the board
A6: SHIELD101.AD6; also elsewhere on the board
A7: SHIELD101.AD7; also elsewhere on the board
AD14: SHIELD101.AD14 (AD14-CANRX); also elsewhere on the board
AD15: SHIELD101.AD15 (AD15-CANTX); also elsewhere on the board
AM-VIN: SHIELD101.V_IN; also elsewhere on the board
D2-FET6: SHIELD101.2 (D2); also elsewhere on the board
D8: SHIELD101.8 (D8); also elsewhere on the board
D9: SHIELD101.9 (D9); also elsewhere on the board
D10: SHIELD101.10 (D10); also elsewhere on the board
D11-FET4: SHIELD101.11 (D11); also elsewhere on the board
D12-FET5: SHIELD101.12 (D12); also elsewhere on the board
D13: Q101.G, SHIELD101.13 (D13)
D23: J2.1, SHIELD101.23 (D23); also elsewhere on the board
D25: J2.3, SHIELD101.25 (D25); also elsewhere on the board
D27: J2.5, SHIELD101.27 (D27); also elsewhere on the board
D29: J2.7, SHIELD101.29 (D29); also elsewhere on the board
D31: J2.9, SHIELD101.31 (D31); also elsewhere on the board
D32: SHIELD101.32 (D32); also elsewhere on the board
D33: J2.11, SHIELD101.33 (D33); also elsewhere on the board
D35: SHIELD101.35 (D35); also elsewhere on the board
D37: SHIELD101.37 (D37); also elsewhere on the board
D39: SHIELD101.39 (D39); also elsewhere on the board
D41: SHIELD101.41 (D41); also elsewhere on the board
D43: SHIELD101.43 (D43); also elsewhere on the board
D45: SHIELD101.45 (D45); also elsewhere on the board
D47: SHIELD101.47 (D47); also elsewhere on the board
D49: SHIELD101.49 (D49); also elsewhere on the board
D50-MISO: SHIELD101.50 (D50-MISO); also elsewhere on the board
D51-MOSI: SHIELD101.51 (D51-MOSI); also elsewhere on the board
D52-SCK: SHIELD101.52 (D52-SCK); also elsewhere on the board
DUE_5V: SHIELD101.5V; also elsewhere on the board
E0_DIR: SHIELD101.28 (D28); also elsewhere on the board
E0_EN: SHIELD101.42 (D42); also elsewhere on the board
E0_STEP: SHIELD101.36 (D36); also elsewhere on the board
ESTOP: SHIELD101.40 (D40); also elsewhere on the board
GND: P102.2 (PM), Q101.S, SHIELD101.GND, SHIELD101.GND6 (GND), SW101.2; also elsewhere on the board
GNDA: SHIELD101.GND4 (GND), SHIELD101.GND5 (GND); also elsewhere on the board
IOREF: SHIELD101.IORF (IOREF); also elsewhere on the board
MISO: SHIELD101.MISO; also elsewhere on the board
MOSI: SHIELD101.MOSI; also elsewhere on the board
unnamed: D101.1 (K), R101.1
unnamed: Q101.D, R101.2
PS-ON: SHIELD101.53 (D53-SS); also elsewhere on the board
SCK: SHIELD101.SCK; also elsewhere on the board
SCL: SHIELD101.21 (D21-SCL); also elsewhere on the board
SCL1: SHIELD101.SCL1; also elsewhere on the board
SDA: SHIELD101.20 (D20-SDA); also elsewhere on the board
SDA1: SHIELD101.SDA1; also elsewhere on the board
SERVO1: SHIELD101.7 (D7); also elsewhere on the board
SERVO2: SHIELD101.6 (D6); also elsewhere on the board
SERVO3: SHIELD101.5 (D5); also elsewhere on the board
SERVO4: SHIELD101.3 (D3); also elsewhere on the board
SPI_CS1: SHIELD101.4 (D4); also elsewhere on the board
THERM0: SHIELD101.AD0; also elsewhere on the board
THERM1: SHIELD101.AD1; also elsewhere on the board
THERM2: SHIELD101.AD2; also elsewhere on the board
THERM3: SHIELD101.AD3; also elsewhere on the board
UART0_RX_LV: SHIELD101.0 (D0-RX0); also elsewhere on the board
UART0_TX_LV: SHIELD101.1 (D1-TX0); also elsewhere on the board
UART1_RX_LV: SHIELD101.19 (D19-RX1); also elsewhere on the board
UART1_TX_LV: SHIELD101.18 (D18-TX1); also elsewhere on the board
UART2_RX_LV: SHIELD101.17 (D17-RX2); also elsewhere on the board
UART2_TX_LV: SHIELD101.16 (D16-TX2); also elsewhere on the board
UART3_RX_LV: SHIELD101.15 (D15-RX3); also elsewhere on the board
UART3_TX_LV: SHIELD101.14 (D14-TX3); also elsewhere on the board
X-MAX: SHIELD101.30 (D30); also elsewhere on the board
X-MIN: SHIELD101.22 (D22); also elsewhere on the board
X_DIR: SHIELD101.AD8; also elsewhere on the board
X_EN: SHIELD101.48 (D48); also elsewhere on the board
X_STEP: SHIELD101.AD9; also elsewhere on the board
Y-MAX: SHIELD101.38 (D38); also elsewhere on the board
Y-MIN: SHIELD101.24 (D24); also elsewhere on the board
Y_DIR: SHIELD101.AD10; also elsewhere on the board
Y_EN: SHIELD101.46 (D46); also elsewhere on the board
Y_STEP: SHIELD101.AD11; also elsewhere on the board
Z-MAX: SHIELD101.34 (D34); also elsewhere on the board
Z-MIN: SHIELD101.26 (D26); also elsewhere on the board
Z_DIR: SHIELD101.AD12 (DAC0-AD12); also elsewhere on the board
Z_EN: SHIELD101.44 (D44); also elsewhere on the board
Z_STEP: SHIELD101.AD13 (DAC1-AD13); also elsewhere on the board

Notes on the sheet:
Also used by Programming USB port
X/Y/Z pins are on single port for both Mega and Due
Reset
Status LED
LED

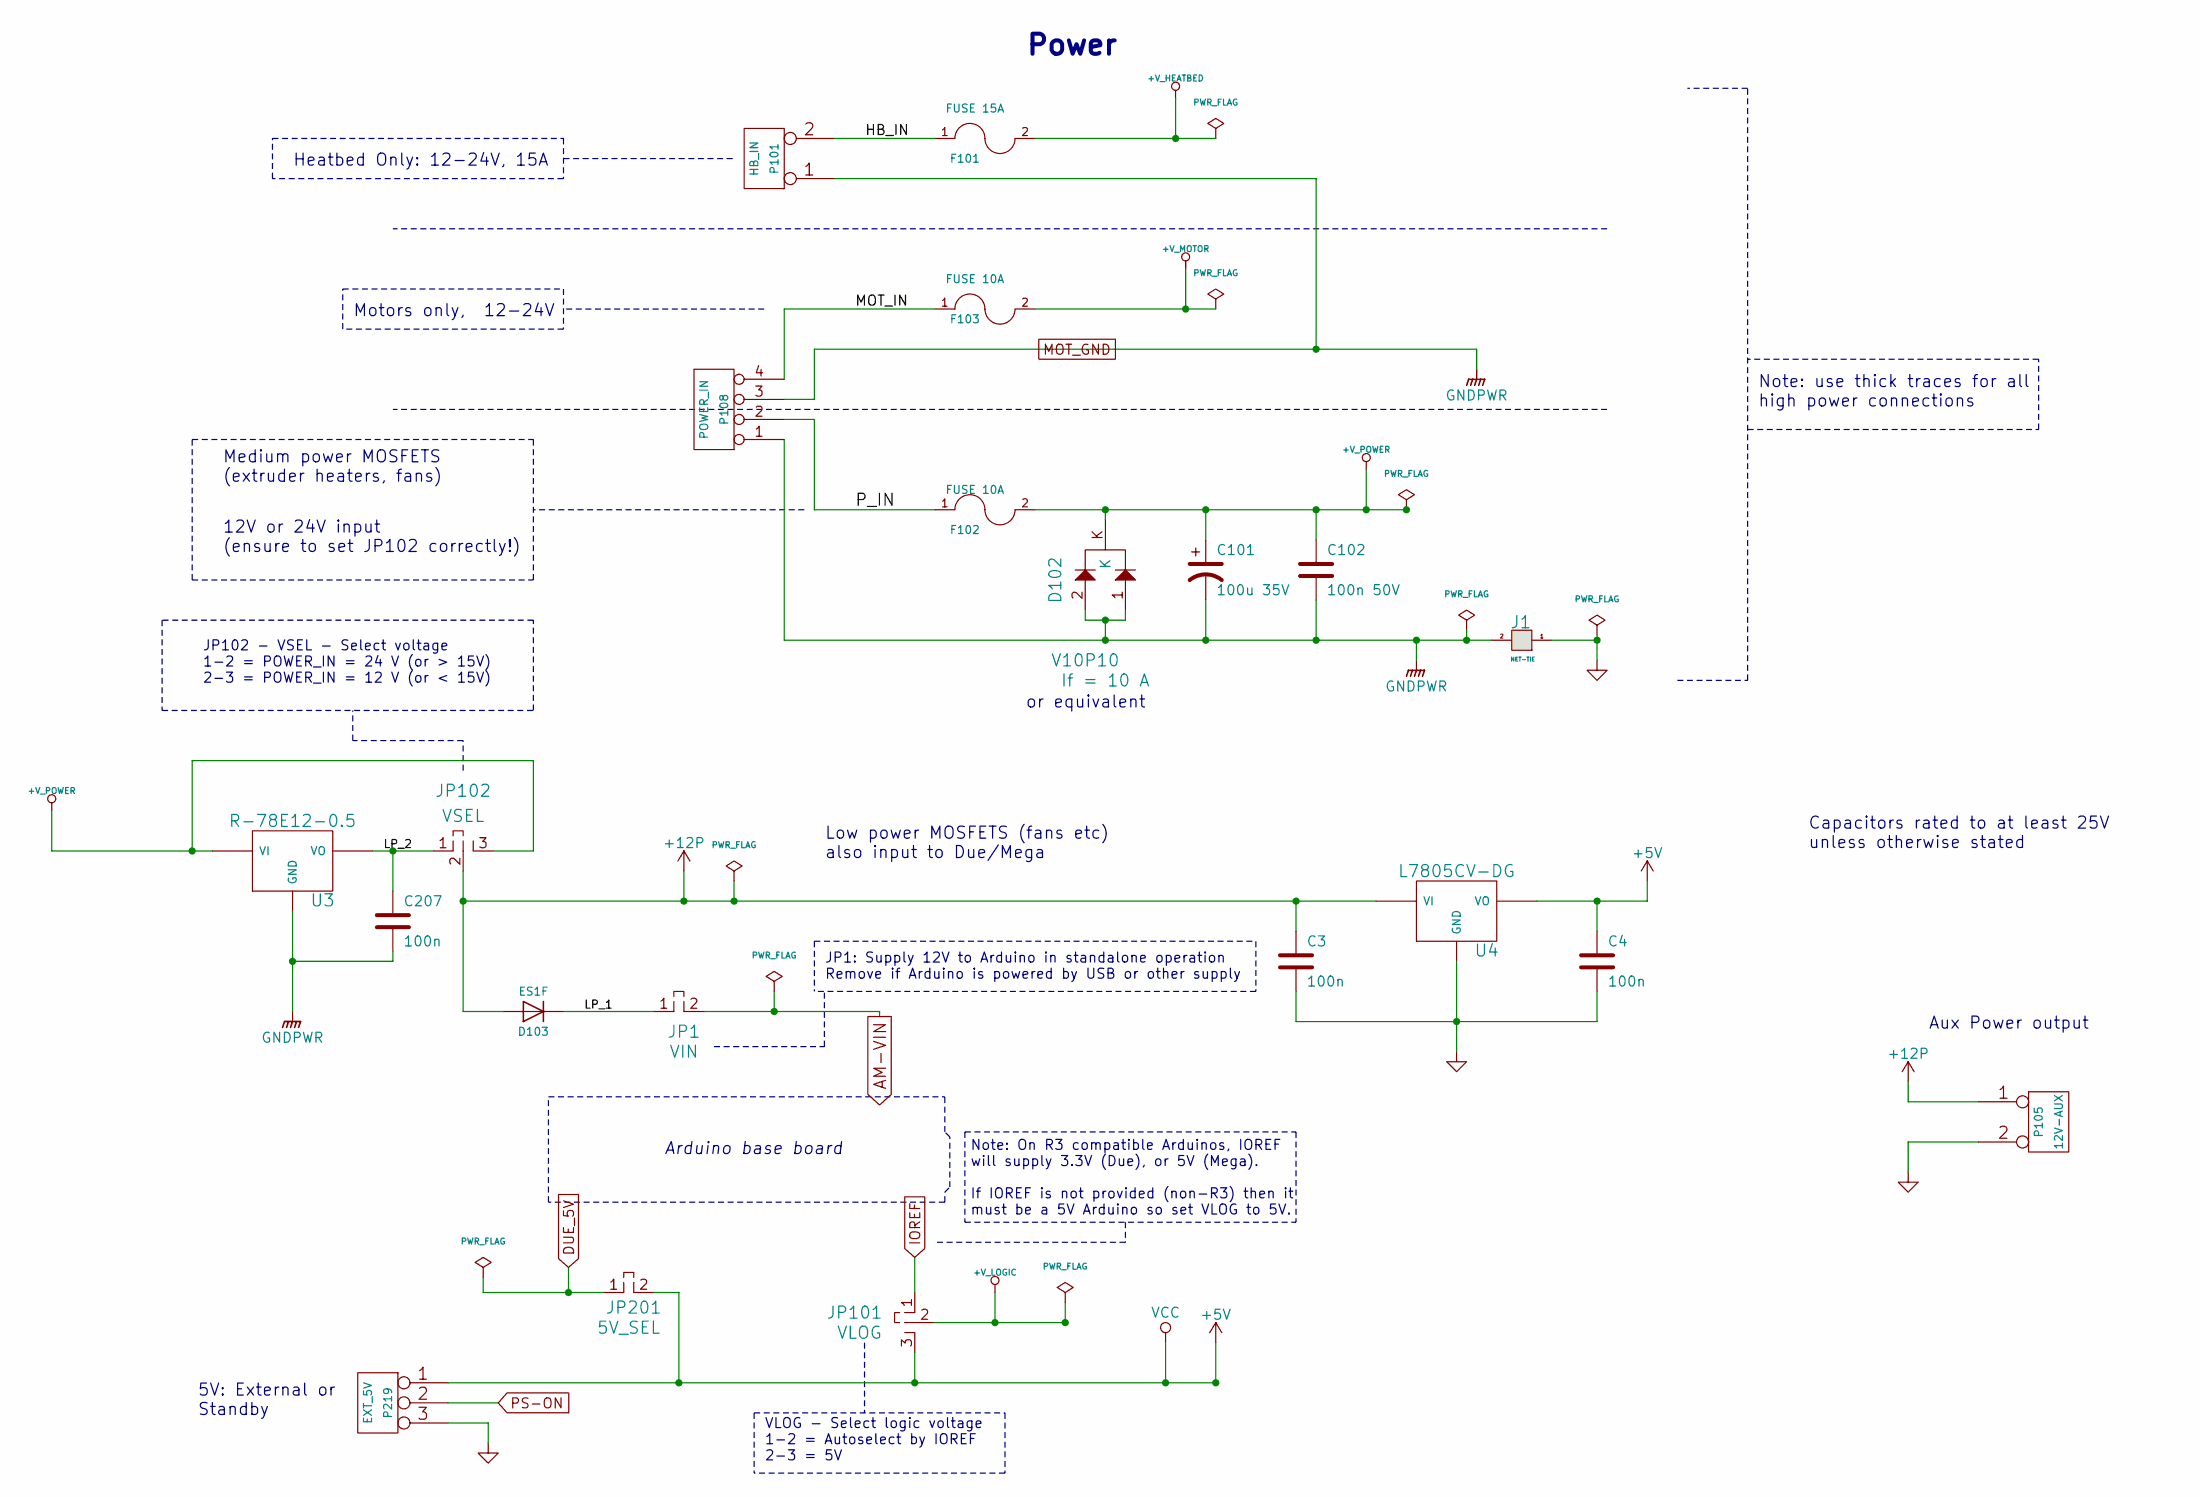
[picture p13: schematic Power.sch, RAMPS-FD (RAMPS for Arduino Due)]

Parts:
C3, C4, C207: 100n; C_0603
C101: 100u 35V; CP_Elec_6.3x7.7
C102: 100n 50V; C_0603
D102: V10P10; TO277A_RMC
D103: ES1F; DO-214AC
F101: FUSE 15A; Keystone_3568
F102, F103: FUSE 10A; Keystone_3568
J1: NET-TIE; TIE-1MM
JP1: VIN; Pin_Header_Straight_1x02_Pitch2.54mm
JP101: VLOG; Pin_Header_Straight_1x03_Pitch2.54mm
JP102: VSEL; Pin_Header_Straight_1x03_Pitch2.54mm
JP201: 5V_SEL; Pin_Header_Straight_1x02_Pitch2.54mm
P101: HB_IN; mstba_2,5%2f2-g-5,08
P105: 12V-AUX; CONN_KK_2.54_2W
P108: POWER_IN; mstba_2,5%2f4-g-5,08
P219: EXT_5V; CONN_KK_2.54_3W
U3: R-78E12-0.5; LM78XXV
U4: L7805CV-DG; LM78XXV

Connections:
+5V: C4.1, JP101.3, JP201.2, P219.1, U4.VO; also elsewhere on the board
+12P: C3.1, D103.2 (A), JP102.2, P105.1, U4.VI; also elsewhere on the board
+V_HEATBED: F101.2; also elsewhere on the board
+V_LOGIC: JP101.2; also elsewhere on the board
+V_MOTOR: F103.2; also elsewhere on the board
+V_POWER: C101.1, C102.1, D102.K, F102.2, JP102.3, U3.VI; also elsewhere on the board
/Power/HB_IN: F101.1, P101.2 (PM)
/Power/LP_1: D103.1 (K), JP1.1
/Power/LP_2: C207.1, JP102.1, U3.VO
/Power/MOT_IN: F103.1, P108.4
/Power/P_IN: F102.1, P108.2
AM-VIN: JP1.2; also elsewhere on the board
DUE_5V: JP201.1; also elsewhere on the board
GND: C3.2, C4.2, J1.1, P105.2 (PM), P219.3, U4.GND; also elsewhere on the board
IOREF: JP101.1; also elsewhere on the board
MOT_GND: C101.2, C102.2, C207.2, D102.1, D102.2, J1.2, P101.1, P108.1, P108.3, U3.GND; also elsewhere on the board
PS-ON: P219.2 (PM); also elsewhere on the board

Notes on the sheet:
JP102 - VSEL - Select voltage 1-2 = POWER_IN = 24 V (or > 15V) 2-3 = POWER_IN = 12 V (or < 15V)
Low power MOSFETS (fans etc) also input to Due/Mega
Aux Power output
VLOG - Select logic voltage 1-2 = Autoselect by IOREF 2-3 = 5V
Medium power MOSFETS (extruder heaters, fans)
Heatbed Only: 12-24V, 15A
Motors only, 12-24V
Power
JP1: Supply 12V to Arduino in standalone operation Remove if Arduino is powered by USB or other supply
Note: use thick traces for all high power connections
12V or 24V input (ensure to set JP102 correctly!)
5V: External or Standby
or equivalent
Arduino base board
Note: On R3 compatible Arduinos, IOREF will supply 3.3V (Due), or 5V (Mega). If IOREF is not provided (non-R3) then it must be a 5V Arduino so set VLOG to 5V.
Capacitors rated to at least 25V unless otherwise stated

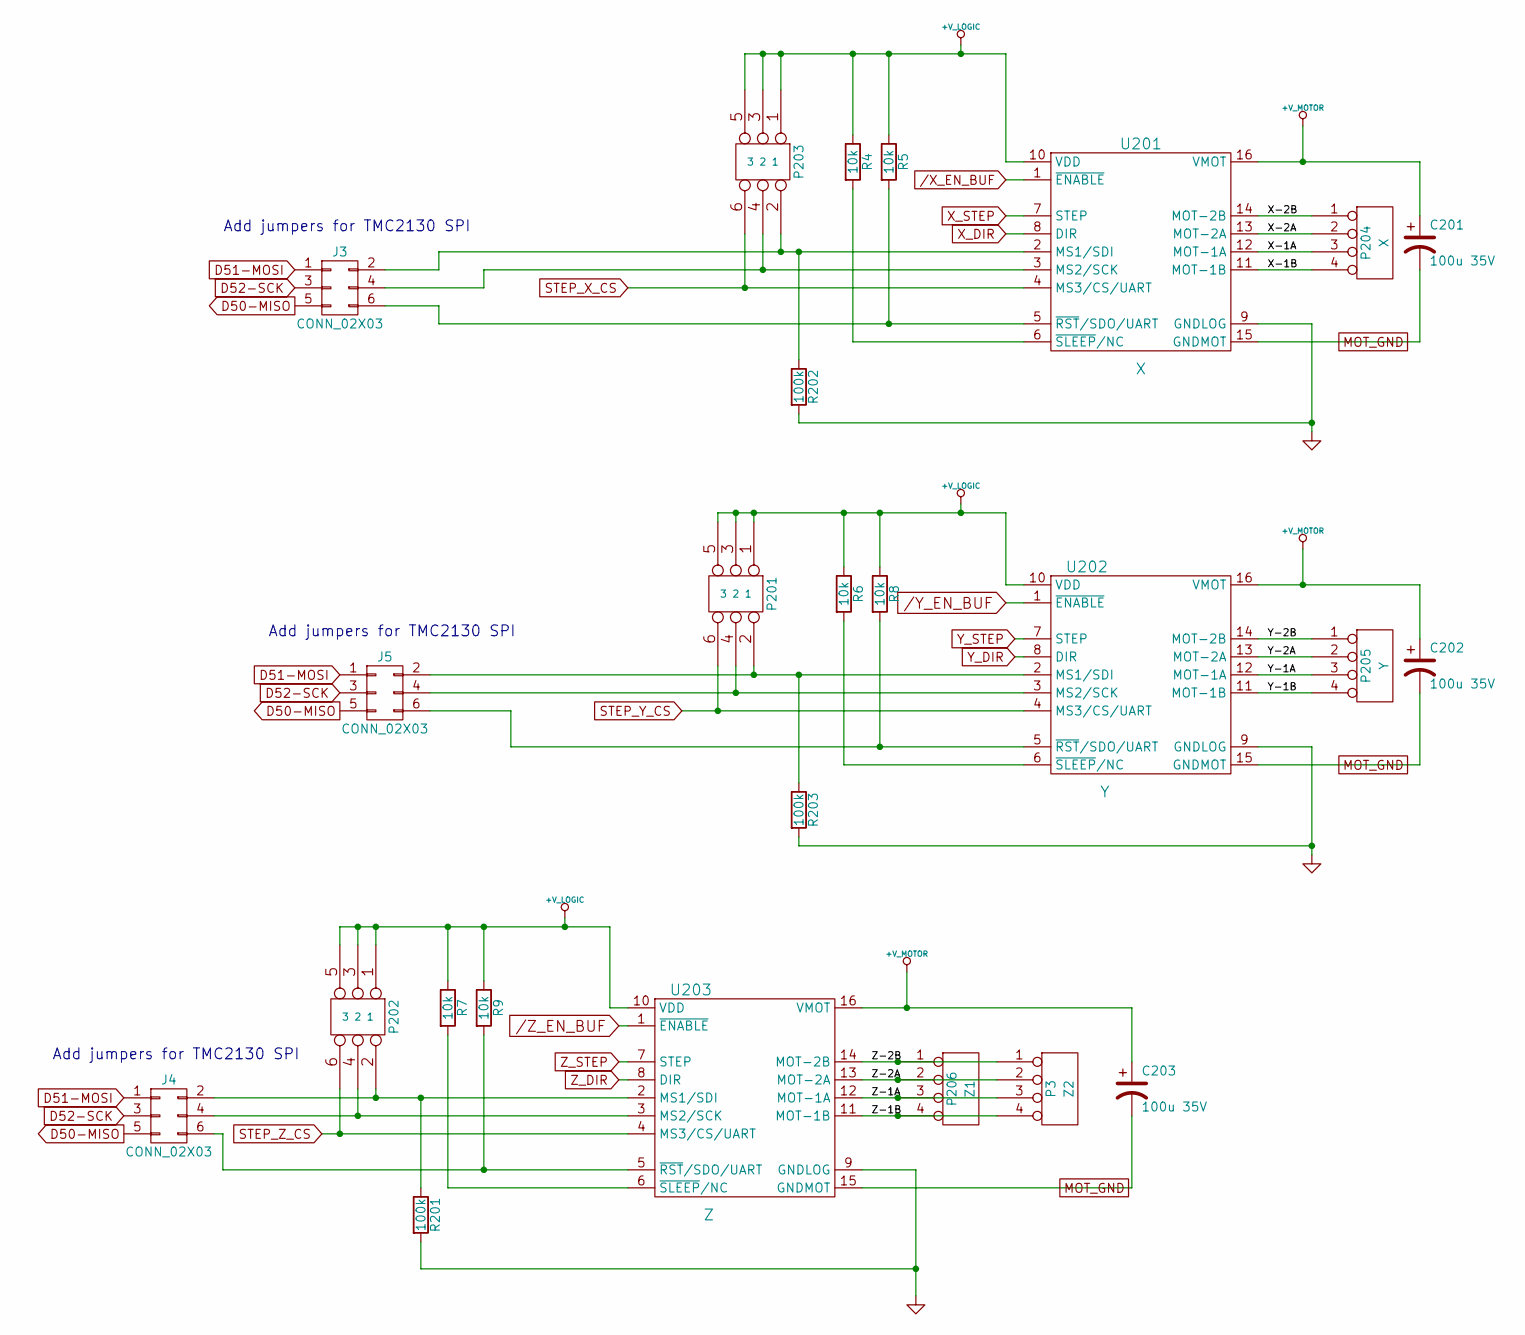
[picture p14: schematic steppers.sch, RAMPS-FD (RAMPS for Arduino Due)]

Parts:
C201, C202, C203: 100u 35V; CP_Elec_6.3x7.7
J3, J4, J5: CONN_02X03; Pin_Header_Straight_2x03_Pitch2.54mm
P3: Z2; CONN_KK_2.54_4W
P201, P202, P203: 3 2 1; Pin_Header_Straight_2x03_Pitch2.54mm
P204: X; CONN_KK_2.54_4W
P205: Y; CONN_KK_2.54_4W
P206: Z1; CONN_KK_2.54_4W
R4, R5, R6, R7, R8, R9: 10k; R_0603
R201, R202, R203: 100k; R_0603
U201: X; POLOLU
U202: Y; POLOLU
U203: Z; POLOLU

Connections:
+V_LOGIC: P201.1, P201.3, P201.5, P202.1, P202.3, P202.5, P203.1, P203.3, P203.5, R4.1, R5.1, R6.1, R7.1, R8.1, R9.1, U201.10 (VDD), U202.10 (VDD), U203.10 (VDD); also elsewhere on the board
+V_MOTOR: C201.1, C202.1, C203.1, U201.16 (VMOT), U202.16 (VMOT), U203.16 (VMOT); also elsewhere on the board
/Stepper Drivers/X-1A: P204.3, U201.12 (MOT-1A)
/Stepper Drivers/X-1B: P204.4, U201.11 (MOT-1B)
/Stepper Drivers/X-2A: P204.2, U201.13 (MOT-2A)
/Stepper Drivers/X-2B: P204.1, U201.14 (MOT-2B)
/Stepper Drivers/Y-1A: P205.3, U202.12 (MOT-1A)
/Stepper Drivers/Y-1B: P205.4, U202.11 (MOT-1B)
/Stepper Drivers/Y-2A: P205.2, U202.13 (MOT-2A)
/Stepper Drivers/Y-2B: P205.1, U202.14 (MOT-2B)
/Stepper Drivers/Z-1A: P3.3, P206.3, U203.12 (MOT-1A)
/Stepper Drivers/Z-1B: P3.4, P206.4, U203.11 (MOT-1B)
/Stepper Drivers/Z-2A: P3.2, P206.2, U203.13 (MOT-2A)
/Stepper Drivers/Z-2B: P3.1, P206.1, U203.14 (MOT-2B)
/X_EN_BUF: U201.1 (~ENABLE); also elsewhere on the board
/Y_EN_BUF: U202.1 (~ENABLE); also elsewhere on the board
/Z_EN_BUF: U203.1 (~ENABLE); also elsewhere on the board
GND: R201.2, R202.2, R203.2, U201.9 (GNDLOG), U202.9 (GNDLOG), U203.9 (GNDLOG); also elsewhere on the board
MOT_GND: C201.2, C202.2, C203.2, U201.15 (GNDMOT), U202.15 (GNDMOT), U203.15 (GNDMOT); also elsewhere on the board
unnamed: J3.1, J4.1, J5.1
unnamed: J3.2, P203.2, R202.1, U201.2 (MS1/SDI)
unnamed: J3.3, J4.3, J5.3
unnamed: J3.4, P203.4, U201.3 (MS2/SCK)
unnamed: J3.5, J4.5, J5.5
unnamed: J3.6, R5.2, U201.5 (~RST~/SDO/UART)
unnamed: J4.2, P202.2, R201.1, U203.2 (MS1/SDI)
unnamed: J4.4, P202.4, U203.3 (MS2/SCK)
unnamed: J4.6, R9.2, U203.5 (~RST~/SDO/UART)
unnamed: J5.2, P201.2, R203.1, U202.2 (MS1/SDI)
unnamed: J5.4, P201.4, U202.3 (MS2/SCK)
unnamed: J5.6, R8.2, U202.5 (~RST~/SDO/UART)
unnamed: R4.2, U201.6 (~SLEEP~/NC)
unnamed: R6.2, U202.6 (~SLEEP~/NC)
unnamed: R7.2, U203.6 (~SLEEP~/NC)
STEP_X_CS: P203.6, U201.4 (MS3/CS/UART)
STEP_Y_CS: P201.6, U202.4 (MS3/CS/UART)
STEP_Z_CS: P202.6, U203.4 (MS3/CS/UART)
X_DIR: U201.8 (DIR); also elsewhere on the board
X_STEP: U201.7 (STEP); also elsewhere on the board
Y_DIR: U202.8 (DIR); also elsewhere on the board
Y_STEP: U202.7 (STEP); also elsewhere on the board
Z_DIR: U203.8 (DIR); also elsewhere on the board
Z_STEP: U203.7 (STEP); also elsewhere on the board

Notes on the sheet:
Add jumpers for TMC2130 SPI

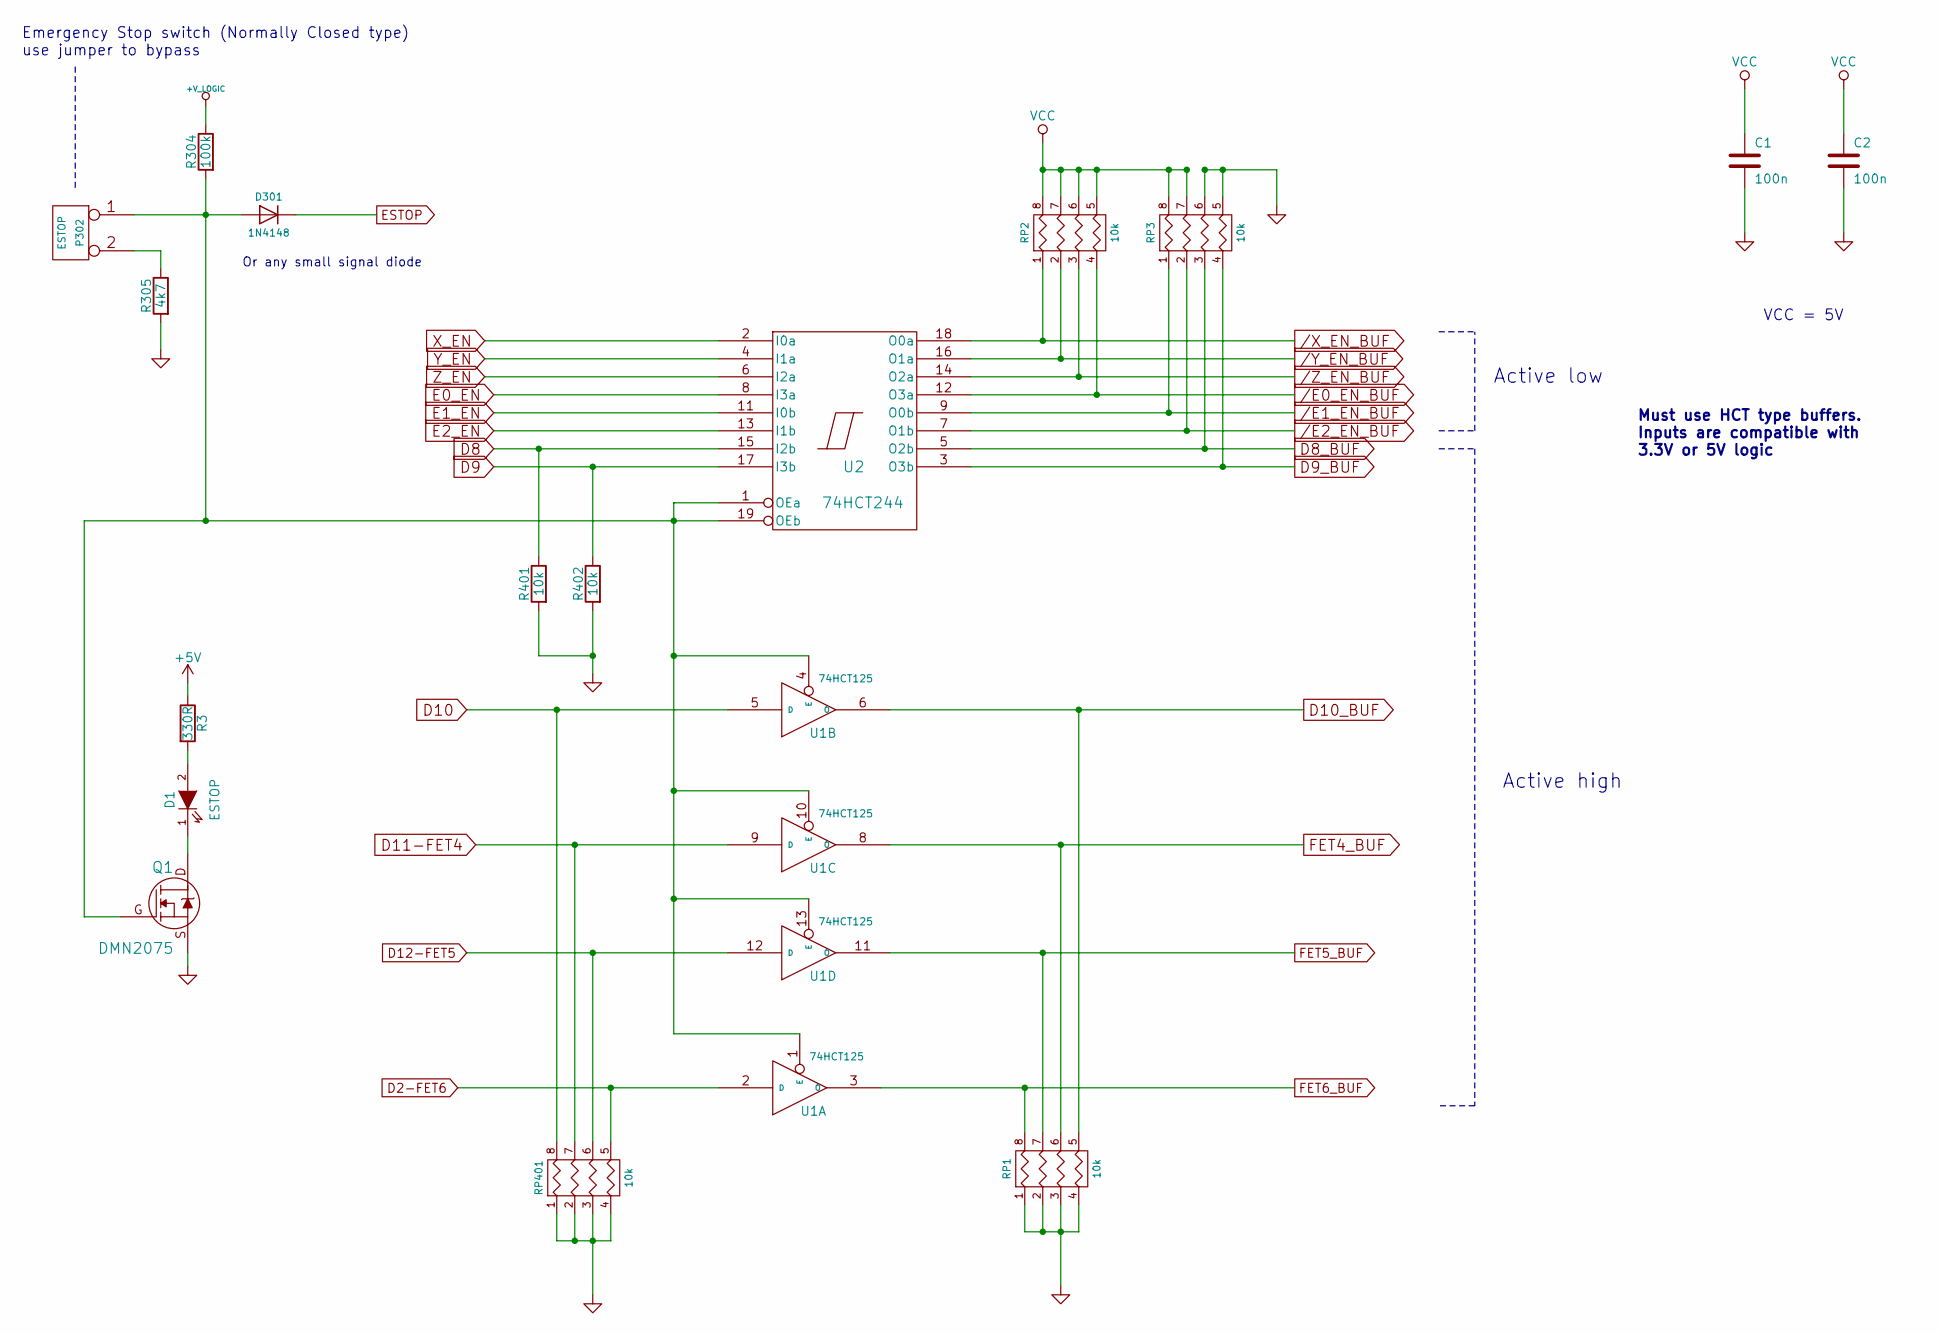
[picture p15: schematic e-stop.sch, RAMPS-FD (RAMPS for Arduino Due)]

Parts:
C1, C2: 100n; C_0603
D1: ESTOP; LED-0805_GREEN
D301: 1N4148; SOD-123
P302: ESTOP; CONN_KK_2.54_2W
Q1: DMN2075; SOT23GDS
R3: 330R; R_0603
R304: 100k; R_0603
R305: 4k7; R_0603
R401, R402: 10k; R_0603
RP1, RP2, RP3, RP401: 10k; R_Cat16-4
U1: 74HCT125; TSSOP-14_4.4x5mm_Pitch0.65mm
U2: 74HCT244; TSSOP-20_4.4x6.5mm_Pitch0.65mm

Connections:
+5V: C1.1, C2.1, R3.1, RP2.5 (R4), RP2.6 (R3), RP2.7 (R2), RP2.8 (R1), RP3.7 (R2), RP3.8 (R1), U1.14 (VCC), U2.20 (VCC); also elsewhere on the board
+V_LOGIC: R304.1; also elsewhere on the board
/E0_EN_BUF: RP2.4, U2.12 (O3a); also elsewhere on the board
/E1_EN_BUF: RP3.1, U2.9 (O0b); also elsewhere on the board
/E2_EN_BUF: RP3.2, U2.7 (O1b); also elsewhere on the board
/X_EN_BUF: RP2.1, U2.18 (O0a); also elsewhere on the board
/Y_EN_BUF: RP2.2, U2.16 (O1a); also elsewhere on the board
/Z_EN_BUF: RP2.3, U2.14 (O2a); also elsewhere on the board
D2-FET6: RP401.5 (R4), U1.2 (D); also elsewhere on the board
D8: R401.1, U2.15 (I2b); also elsewhere on the board
D8_BUF: RP3.3, U2.5 (O2b); also elsewhere on the board
D9: R402.1, U2.17 (I3b); also elsewhere on the board
D9_BUF: RP3.4, U2.3 (O3b); also elsewhere on the board
D10: RP401.8 (R1), U1.5 (D); also elsewhere on the board
D10_BUF: RP1.5 (R4), U1.6 (O); also elsewhere on the board
D11-FET4: RP401.7 (R2), U1.9 (D); also elsewhere on the board
D12-FET5: RP401.6 (R3), U1.12 (D); also elsewhere on the board
D39: U2.11 (I0b); also elsewhere on the board
D45: U2.13 (I1b); also elsewhere on the board
E0_EN: U2.8 (I3a); also elsewhere on the board
ESTOP: D301.1 (K); also elsewhere on the board
FET4_BUF: RP1.6 (R3), U1.8 (O); also elsewhere on the board
FET5_BUF: RP1.7 (R2), U1.11 (O); also elsewhere on the board
FET6_BUF: RP1.8 (R1), U1.3 (O); also elsewhere on the board
GND: C1.2, C2.2, Q1.S, R305.2, R401.2, R402.2, RP1.1, RP1.2, RP1.3, RP1.4, RP3.5 (R4), RP3.6 (R3), RP401.1, RP401.2, RP401.3, RP401.4, U1.7 (GND), U2.10 (GND); also elsewhere on the board
unnamed: D1.1 (K), Q1.D
unnamed: D1.2 (A), R3.2
unnamed: D301.2 (A), P302.1, Q1.G, R304.2, U1.1 (E), U1.4 (E), U1.10 (E), U1.13 (E), U2.1 (OEa), U2.19 (OEb)
unnamed: P302.2 (PM), R305.1
X_EN: U2.2 (I0a); also elsewhere on the board
Y_EN: U2.4 (I1a); also elsewhere on the board
Z_EN: U2.6 (I2a); also elsewhere on the board

Notes on the sheet:
Emergency Stop switch (Normally Closed type) use jumper to bypass
Or any small signal diode
Active low
Active high
VCC = 5V
Must use HCT type buffers. Inputs are compatible with 3.3V or 5V logic

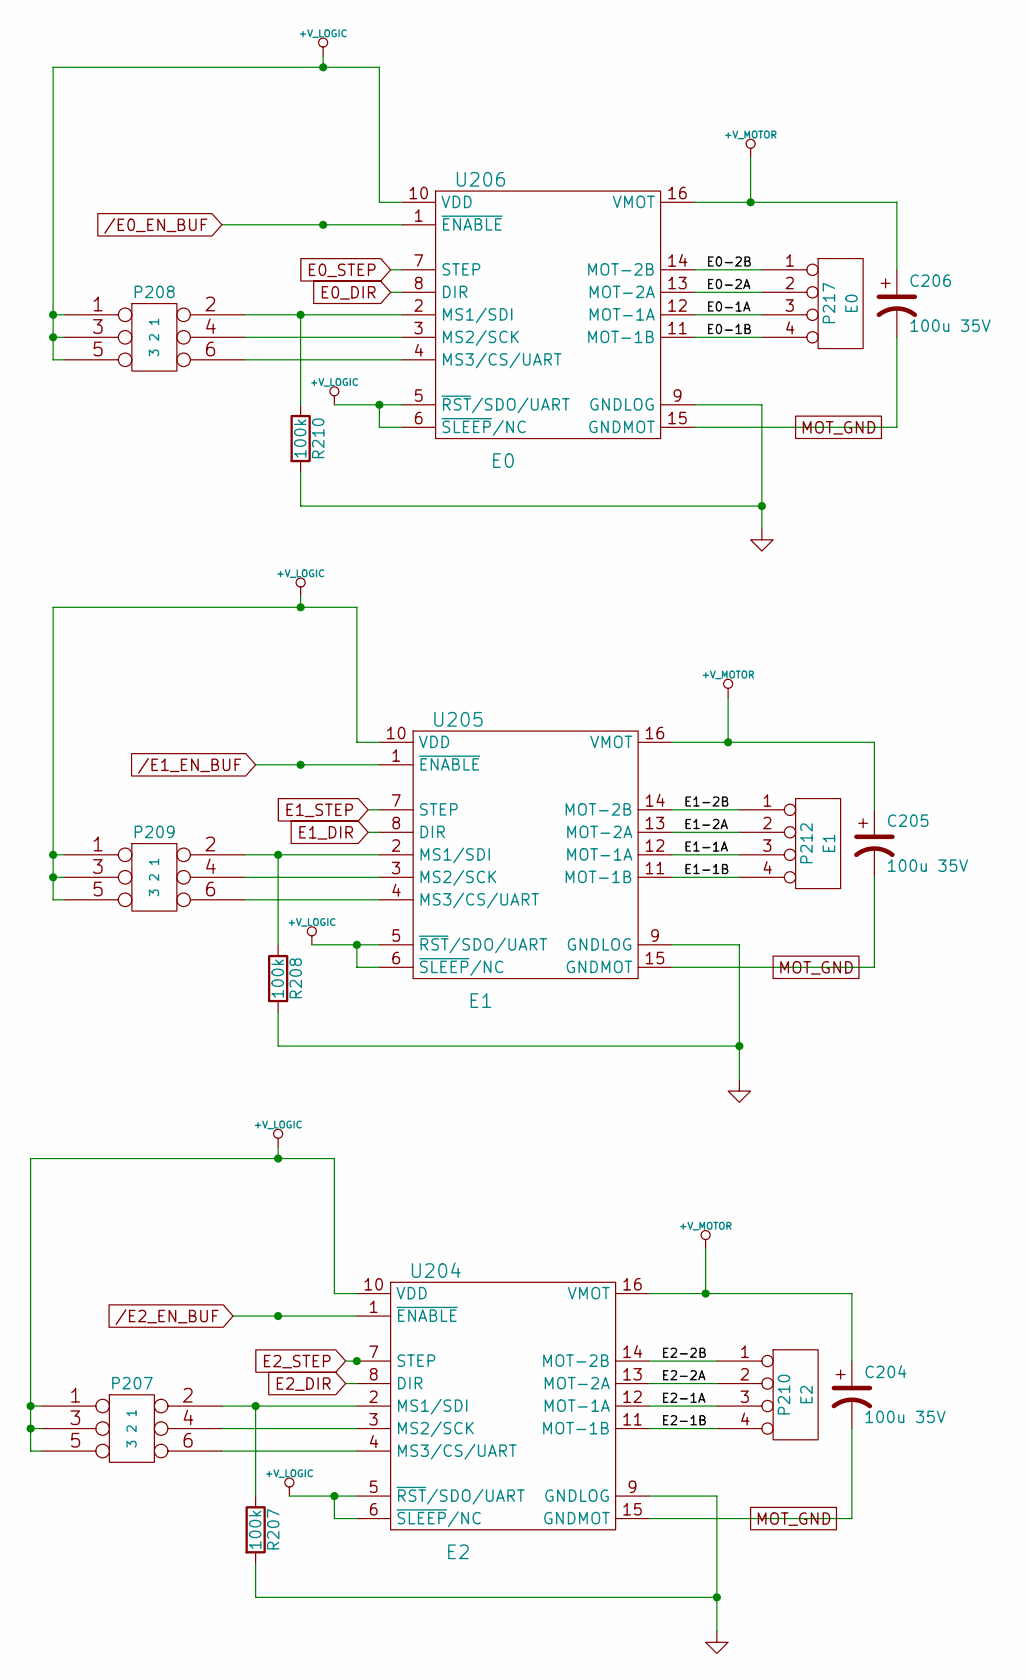
[picture p16: schematic steppers2.sch, RAMPS-FD (RAMPS for Arduino Due)]

Parts:
C204, C205, C206: 100u 35V; CP_Elec_6.3x7.7
P207, P208, P209: 3 2 1; Pin_Header_Straight_2x03_Pitch2.54mm
P210: E2; CONN_KK_2.54_4W
P212: E1; CONN_KK_2.54_4W
P217: E0; CONN_KK_2.54_4W
R207, R208, R210: 100k; R_0603
U204: E2; POLOLU
U205: E1; POLOLU
U206: E0; POLOLU

Connections:
+V_LOGIC: P207.1, P207.3, P207.5, P208.1, P208.3, P208.5, P209.1, P209.3, P209.5, U204.5 (~RST~/SDO/UART), U204.6 (~SLEEP~/NC), U204.10 (VDD), U205.5 (~RST~/SDO/UART), U205.6 (~SLEEP~/NC), U205.10 (VDD), U206.5 (~RST~/SDO/UART), U206.6 (~SLEEP~/NC), U206.10 (VDD); also elsewhere on the board
+V_MOTOR: C204.1, C205.1, C206.1, U204.16 (VMOT), U205.16 (VMOT), U206.16 (VMOT); also elsewhere on the board
/E0_EN_BUF: U206.1 (~ENABLE); also elsewhere on the board
/E1_EN_BUF: U205.1 (~ENABLE); also elsewhere on the board
/E2_EN_BUF: U204.1 (~ENABLE); also elsewhere on the board
/Stepper Drivers 2/E0-1A: P217.3, U206.12 (MOT-1A)
/Stepper Drivers 2/E0-1B: P217.4, U206.11 (MOT-1B)
/Stepper Drivers 2/E0-2A: P217.2, U206.13 (MOT-2A)
/Stepper Drivers 2/E0-2B: P217.1, U206.14 (MOT-2B)
/Stepper Drivers 2/E1-1A: P212.3, U205.12 (MOT-1A)
/Stepper Drivers 2/E1-1B: P212.4, U205.11 (MOT-1B)
/Stepper Drivers 2/E1-2A: P212.2, U205.13 (MOT-2A)
/Stepper Drivers 2/E1-2B: P212.1, U205.14 (MOT-2B)
/Stepper Drivers 2/E2-1A: P210.3, U204.12 (MOT-1A)
/Stepper Drivers 2/E2-1B: P210.4, U204.11 (MOT-1B)
/Stepper Drivers 2/E2-2A: P210.2, U204.13 (MOT-2A)
/Stepper Drivers 2/E2-2B: P210.1, U204.14 (MOT-2B)
D32: U204.7 (STEP); also elsewhere on the board
D41: U205.8 (DIR); also elsewhere on the board
D43: U205.7 (STEP); also elsewhere on the board
D47: U204.8 (DIR); also elsewhere on the board
E0_DIR: U206.8 (DIR); also elsewhere on the board
E0_STEP: U206.7 (STEP); also elsewhere on the board
GND: R207.2, R208.2, R210.2, U204.9 (GNDLOG), U205.9 (GNDLOG), U206.9 (GNDLOG); also elsewhere on the board
MOT_GND: C204.2, C205.2, C206.2, U204.15 (GNDMOT), U205.15 (GNDMOT), U206.15 (GNDMOT); also elsewhere on the board
unnamed: P207.2, R207.1, U204.2 (MS1/SDI)
unnamed: P207.4, U204.3 (MS2/SCK)
unnamed: P207.6, U204.4 (MS3/CS/UART)
unnamed: P208.2, R210.1, U206.2 (MS1/SDI)
unnamed: P208.4, U206.3 (MS2/SCK)
unnamed: P208.6, U206.4 (MS3/CS/UART)
unnamed: P209.2, R208.1, U205.2 (MS1/SDI)
unnamed: P209.4, U205.3 (MS2/SCK)
unnamed: P209.6, U205.4 (MS3/CS/UART)
