bobc/RAMPS-FD/RAMPS-FD/RAMPS-FD.kicad_pcb

## KiCad design RAMPS-FD/RAMPS-FD.kicad_pcb (continued)

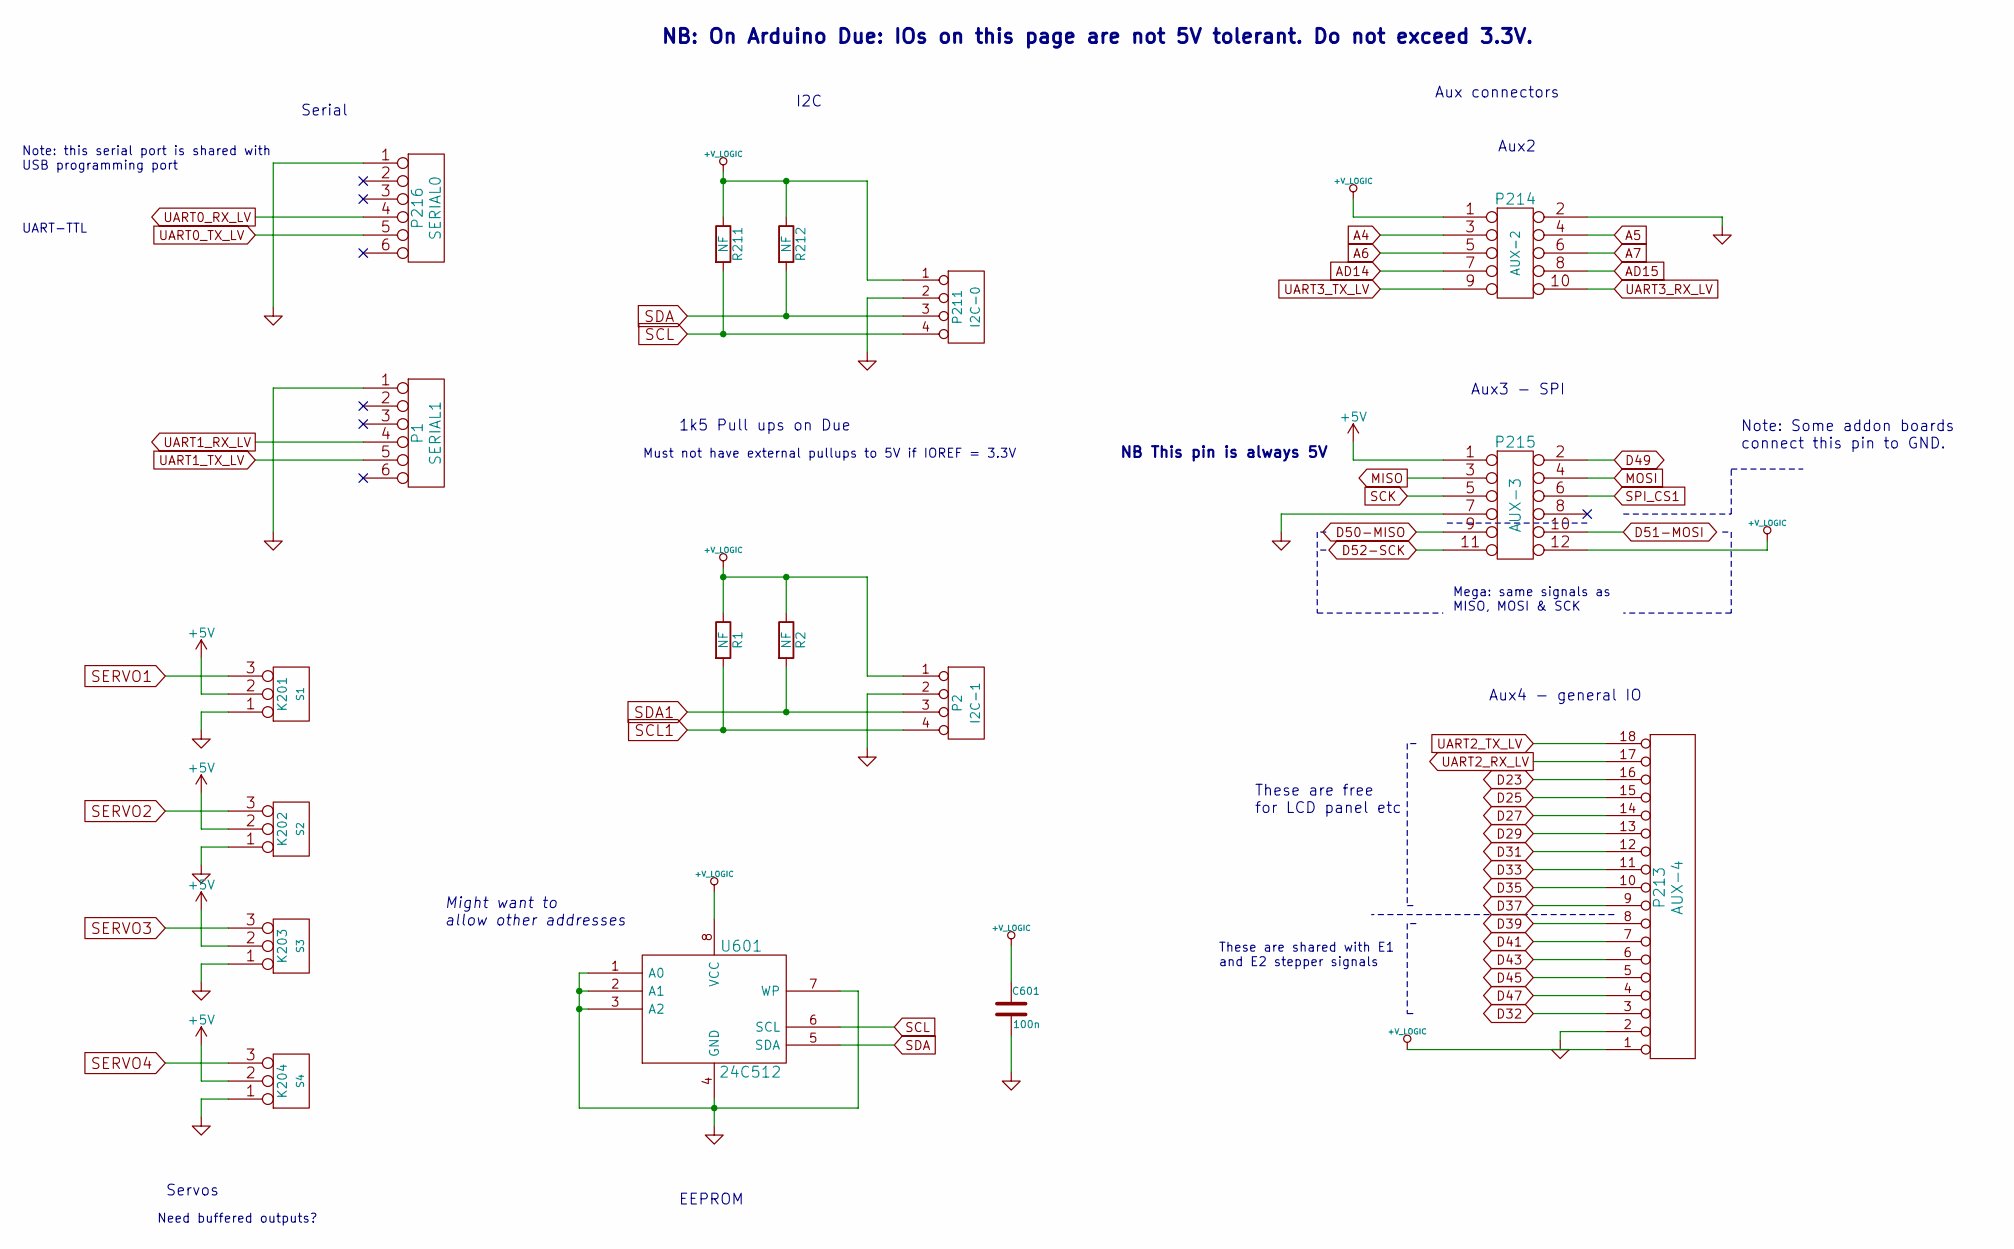
[picture p17: schematic con_misc.sch, RAMPS-FD (RAMPS for Arduino Due)]

Parts:
C601: 100n; C_0603
K201: S1; Pin_Header_Straight_1x03_Pitch2.54mm
K202: S2; Pin_Header_Straight_1x03_Pitch2.54mm
K203: S3; Pin_Header_Straight_1x03_Pitch2.54mm
K204: S4; Pin_Header_Straight_1x03_Pitch2.54mm
P1: SERIAL1; Pin_Header_Straight_1x06_Pitch2.54mm
P2: I2C-1; Pin_Header_Straight_1x04_Pitch2.54mm
P211: I2C-0; Pin_Header_Straight_1x04_Pitch2.54mm
P213: AUX-4; Pin_Header_Straight_1x18_Pitch2.54mm
P214: AUX-2; PIN_ARRAY_5x2_RMC
P215: AUX-3; PIN_ARRAY_6x2_RMC
P216: SERIAL0; Pin_Header_Straight_1x06_Pitch2.54mm
R1, R2, R211, R212: NF; R_0603
U601: 24C512; SO8E

Connections:
+5V: K201.2 (PM), K202.2 (PM), K203.2 (PM), K204.2 (PM), P215.1; also elsewhere on the board
+V_LOGIC: C601.1, P2.1, P211.1, P213.1, P214.1, P215.12, R1.1, R2.1, R211.1, R212.1, U601.8 (VCC); also elsewhere on the board
A4: P214.3; also elsewhere on the board
A5: P214.4; also elsewhere on the board
A6: P214.5; also elsewhere on the board
A7: P214.6; also elsewhere on the board
AD14: P214.7; also elsewhere on the board
AD15: P214.8; also elsewhere on the board
D23: P213.16; also elsewhere on the board
D25: P213.15; also elsewhere on the board
D27: P213.14; also elsewhere on the board
D29: P213.13; also elsewhere on the board
D31: P213.12; also elsewhere on the board
D32: P213.3; also elsewhere on the board
D33: P213.11; also elsewhere on the board
D35: P213.10; also elsewhere on the board
D37: P213.9; also elsewhere on the board
D39: P213.8; also elsewhere on the board
D41: P213.7; also elsewhere on the board
D43: P213.6; also elsewhere on the board
D45: P213.5; also elsewhere on the board
D47: P213.4; also elsewhere on the board
D49: P215.2; also elsewhere on the board
D50-MISO: P215.9; also elsewhere on the board
D51-MOSI: P215.10; also elsewhere on the board
D52-SCK: P215.11; also elsewhere on the board
GND: C601.2, K201.1, K202.1, K203.1, K204.1, P1.1, P2.2, P211.2, P213.2, P214.2, P215.7, P216.1, U601.1 (A0), U601.2 (A1), U601.3 (A2), U601.4 (GND), U601.7 (WP); also elsewhere on the board
MISO: P215.3; also elsewhere on the board
MOSI: P215.4; also elsewhere on the board
SCK: P215.5; also elsewhere on the board
SCL: P211.4, R211.2, U601.6 (SCL); also elsewhere on the board
SCL1: P2.4, R1.2; also elsewhere on the board
SDA: P211.3, R212.2, U601.5 (SDA); also elsewhere on the board
SDA1: P2.3, R2.2; also elsewhere on the board
SERVO1: K201.3; also elsewhere on the board
SERVO2: K202.3; also elsewhere on the board
SERVO3: K203.3; also elsewhere on the board
SERVO4: K204.3; also elsewhere on the board
SPI_CS1: P215.6; also elsewhere on the board
UART0_RX_LV: P216.4; also elsewhere on the board
UART0_TX_LV: P216.5; also elsewhere on the board
UART1_RX_LV: P1.4; also elsewhere on the board
UART1_TX_LV: P1.5; also elsewhere on the board
UART2_RX_LV: P213.17; also elsewhere on the board
UART2_TX_LV: P213.18; also elsewhere on the board
UART3_RX_LV: P214.10; also elsewhere on the board
UART3_TX_LV: P214.9; also elsewhere on the board

Notes on the sheet:
Serial
UART-TTL
Need buffered outputs?
Must not have external pullups to 5V if IOREF = 3.3V
1k5 Pull ups on Due
Aux4 - general IO
Aux3 - SPI
Aux2
Aux connectors
Servos
I2C
NB: On Arduino Due: IOs on this page are not 5V tolerant. Do not exceed 3.3V.
Note: this serial port is shared with USB programming port
These are shared with E1 and E2 stepper signals
Mega: same signals as MISO, MOSI & SCK
NB This pin is always 5V
These are free for LCD panel etc
Note: Some addon boards connect this pin to GND.
EEPROM
Might want to allow other addresses

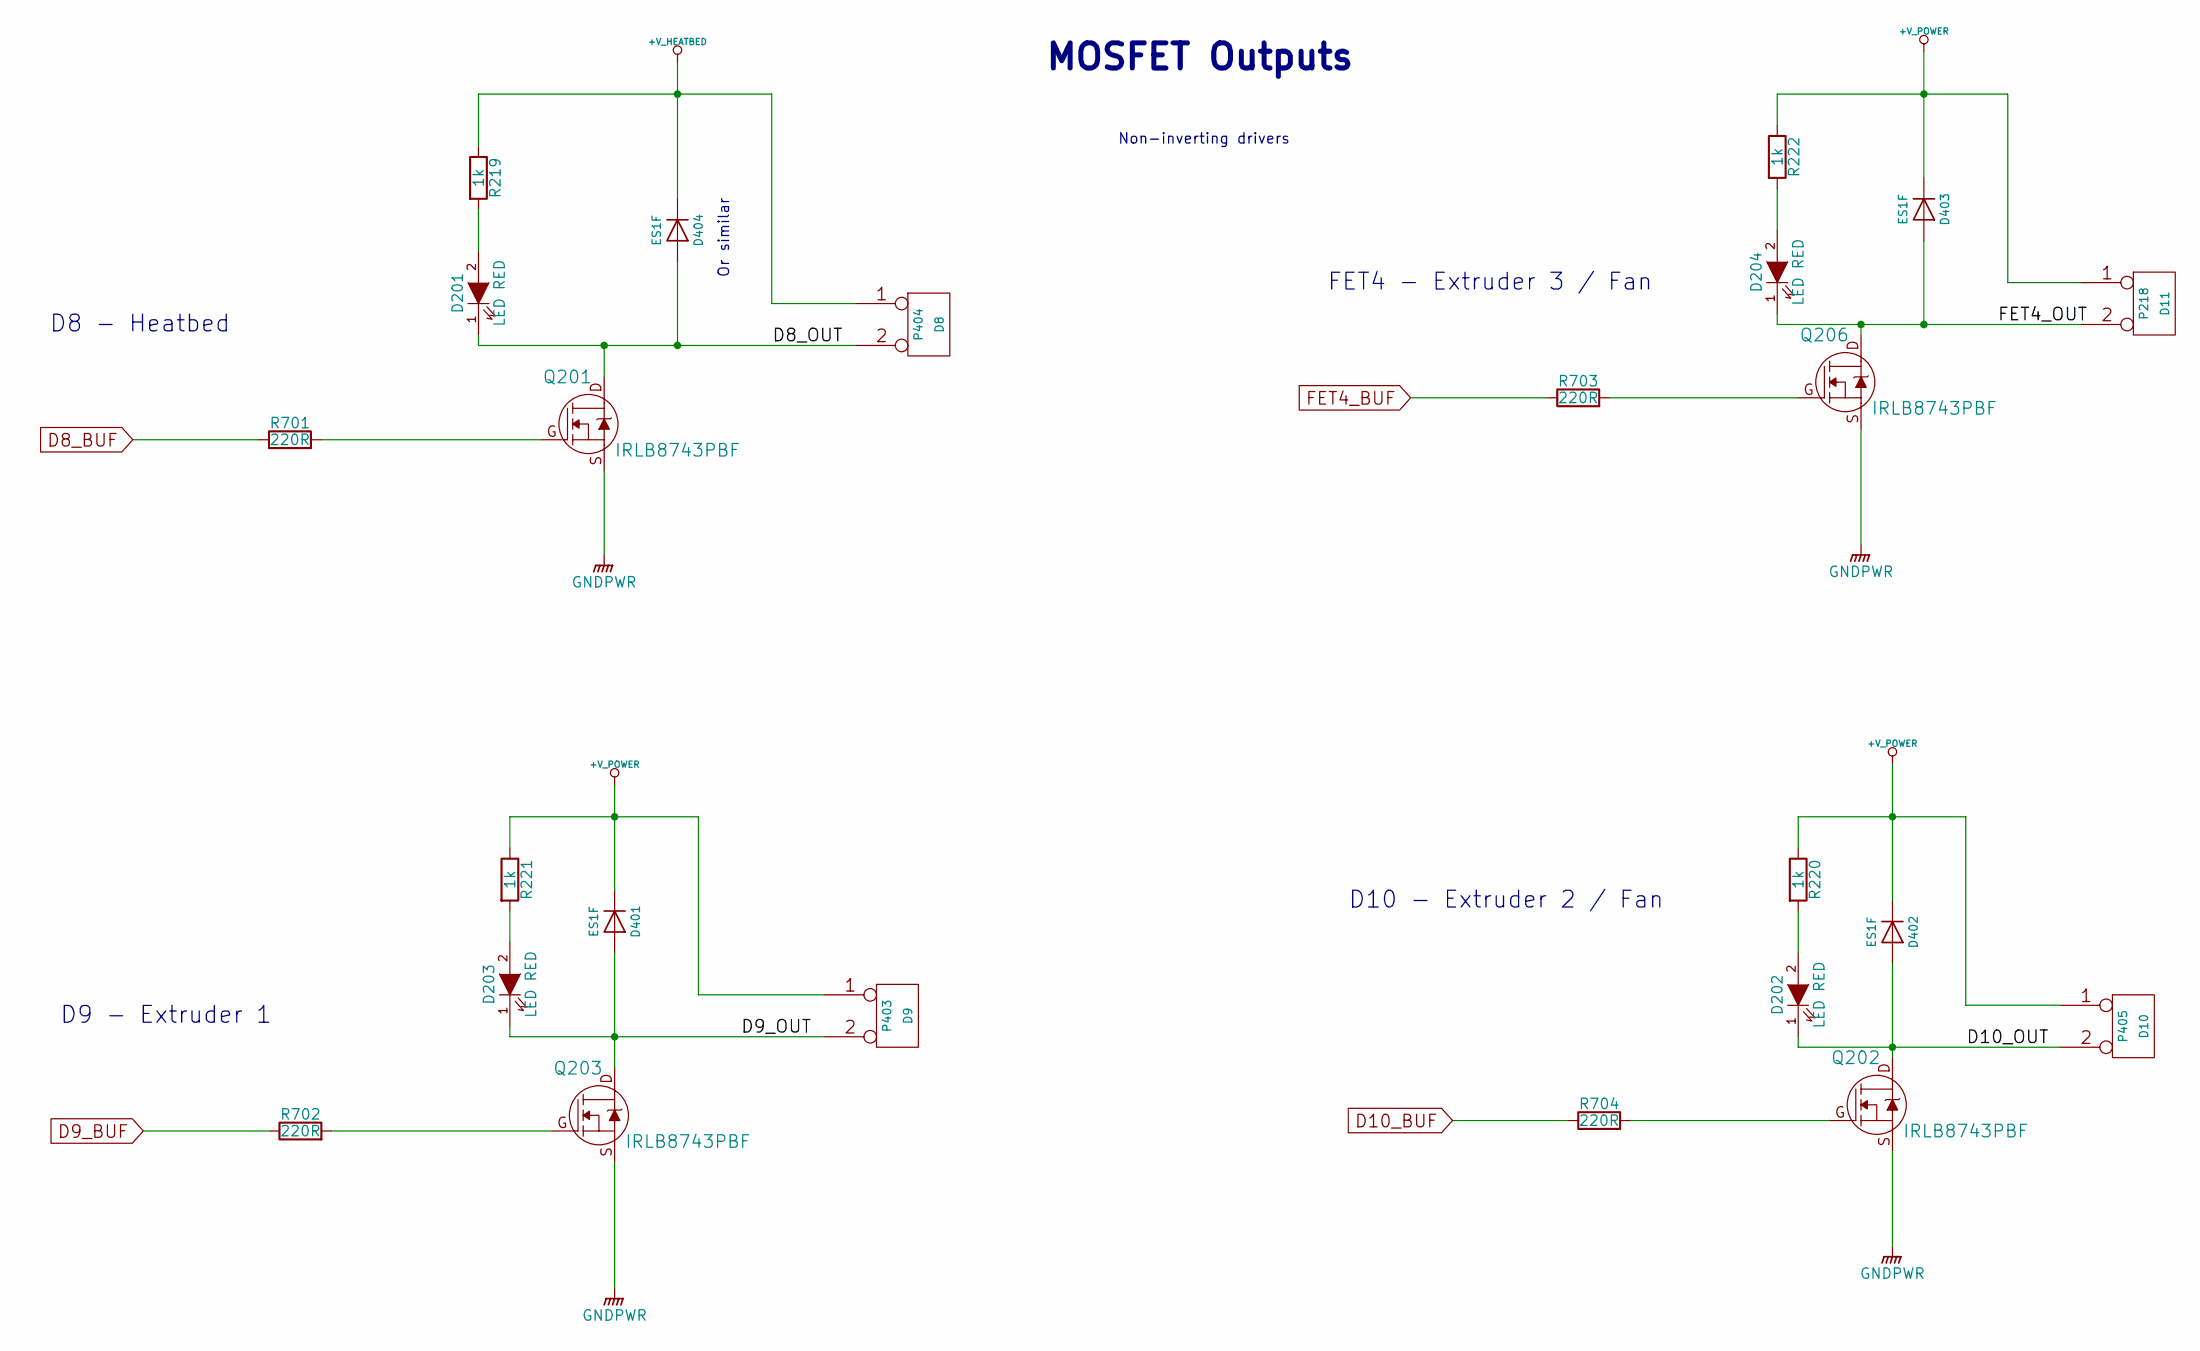
[picture p18: schematic con_outputs.sch, RAMPS-FD (RAMPS for Arduino Due)]

Parts:
D201, D202, D203, D204: LED RED; LED-0805_RED
D401, D402, D403, D404: ES1F; DO-214AC
P218: D11; RMC-pt_1,5-2-3,5-h
P403: D9; RMC-pt_1,5-2-3,5-h
P404: D8; mors_2p
P405: D10; RMC-pt_1,5-2-3,5-h
Q201, Q202, Q203, Q206: IRLB8743PBF; TO-220AB_IRF2804_RMC
R219, R220, R221, R222: 1k; R_0603
R701, R702, R703, R704: 220R; R_0603

Connections:
+V_HEATBED: D404.1 (K), P404.1, R219.1; also elsewhere on the board
+V_POWER: D401.1 (K), D402.1 (K), D403.1 (K), P218.1, P403.1, P405.1, R220.1, R221.1, R222.1; also elsewhere on the board
/Mosfet Outputs/D8_OUT: D201.1 (K), D404.2 (A), P404.2 (PM), Q201.D
/Mosfet Outputs/D9_OUT: D203.1 (K), D401.2 (A), P403.2 (PM), Q203.D
/Mosfet Outputs/D10_OUT: D202.1 (K), D402.2 (A), P405.2 (PM), Q202.D
/Mosfet Outputs/FET4_OUT: D204.1 (K), D403.2 (A), P218.2 (PM), Q206.D
D8_BUF: R701.1; also elsewhere on the board
D9_BUF: R702.1; also elsewhere on the board
D10_BUF: R704.1; also elsewhere on the board
FET4_BUF: R703.1; also elsewhere on the board
MOT_GND: Q201.S, Q202.S, Q203.S, Q206.S; also elsewhere on the board
unnamed: D201.2 (A), R219.2
unnamed: D202.2 (A), R220.2
unnamed: D203.2 (A), R221.2
unnamed: D204.2 (A), R222.2
unnamed: Q201.G, R701.2
unnamed: Q202.G, R704.2
unnamed: Q203.G, R702.2
unnamed: Q206.G, R703.2

Notes on the sheet:
FET4 - Extruder 3 / Fan
D10 - Extruder 2 / Fan
D9 - Extruder 1
D8 - Heatbed
Non-inverting drivers
MOSFET Outputs
Or similar

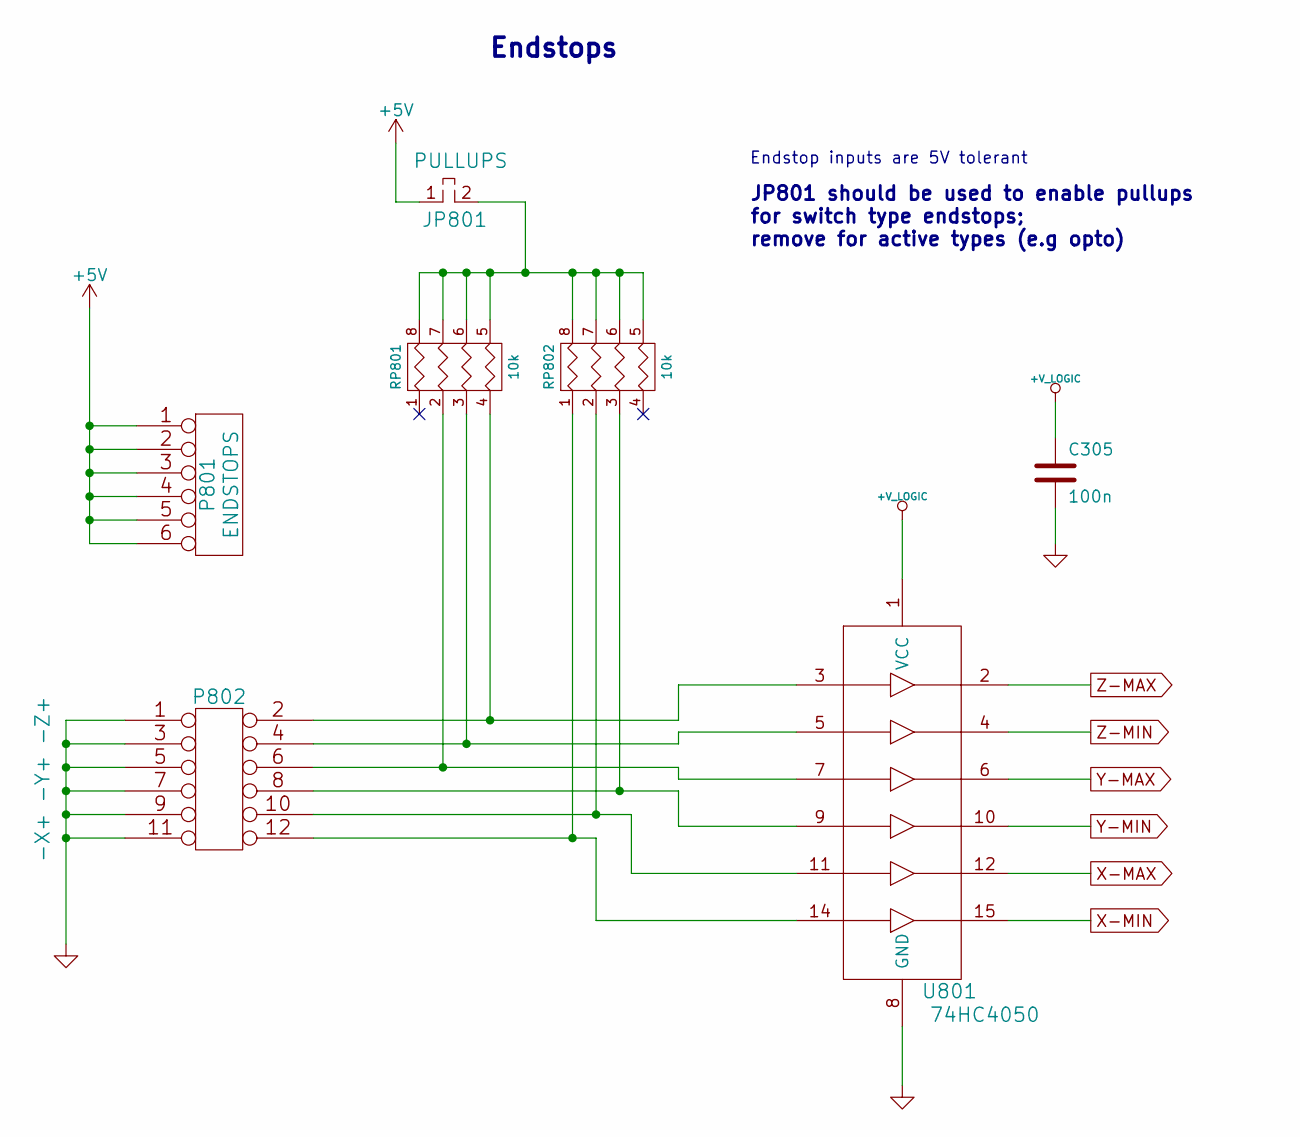
[picture p19: schematic con_inputs.sch, RAMPS-FD (RAMPS for Arduino Due)]

Parts:
C305: 100n; C_0603
JP801: PULLUPS; Pin_Header_Straight_1x02_Pitch2.54mm
P801: ENDSTOPS; Pin_Header_Straight_1x06_Pitch2.54mm
P802: -X+ -Y+ -Z+; Pin_Header_Straight_2x06_Pitch2.54mm
RP801, RP802: 10k; R_Cat16-4
U801: 74HC4050; TSSOP-16_4.4x5mm_Pitch0.65mm

Connections:
+5V: JP801.1, P801.1, P801.2, P801.3, P801.4, P801.5, P801.6; also elsewhere on the board
+V_LOGIC: C305.1, U801.1 (VCC); also elsewhere on the board
GND: C305.2, P802.1, P802.3, P802.5, P802.7, P802.9, P802.11, U801.8 (GND); also elsewhere on the board
unnamed: JP801.2, RP801.5 (R4), RP801.6 (R3), RP801.7 (R2), RP801.8 (R1), RP802.5 (R4), RP802.6 (R3), RP802.7 (R2), RP802.8 (R1)
unnamed: P802.2, RP801.4, U801.3
unnamed: P802.4, RP801.3, U801.5
unnamed: P802.6, RP801.2, U801.7
unnamed: P802.8, RP802.3, U801.9
unnamed: P802.10, RP802.2, U801.11
unnamed: P802.12, RP802.1, U801.14
X-MAX: U801.12; also elsewhere on the board
X-MIN: U801.15; also elsewhere on the board
Y-MAX: U801.6; also elsewhere on the board
Y-MIN: U801.10; also elsewhere on the board
Z-MAX: U801.2; also elsewhere on the board
Z-MIN: U801.4; also elsewhere on the board

Notes on the sheet:
Endstop inputs are 5V tolerant
Endstops
JP801 should be used to enable pullups for switch type endstops; remove for active types (e.g opto)

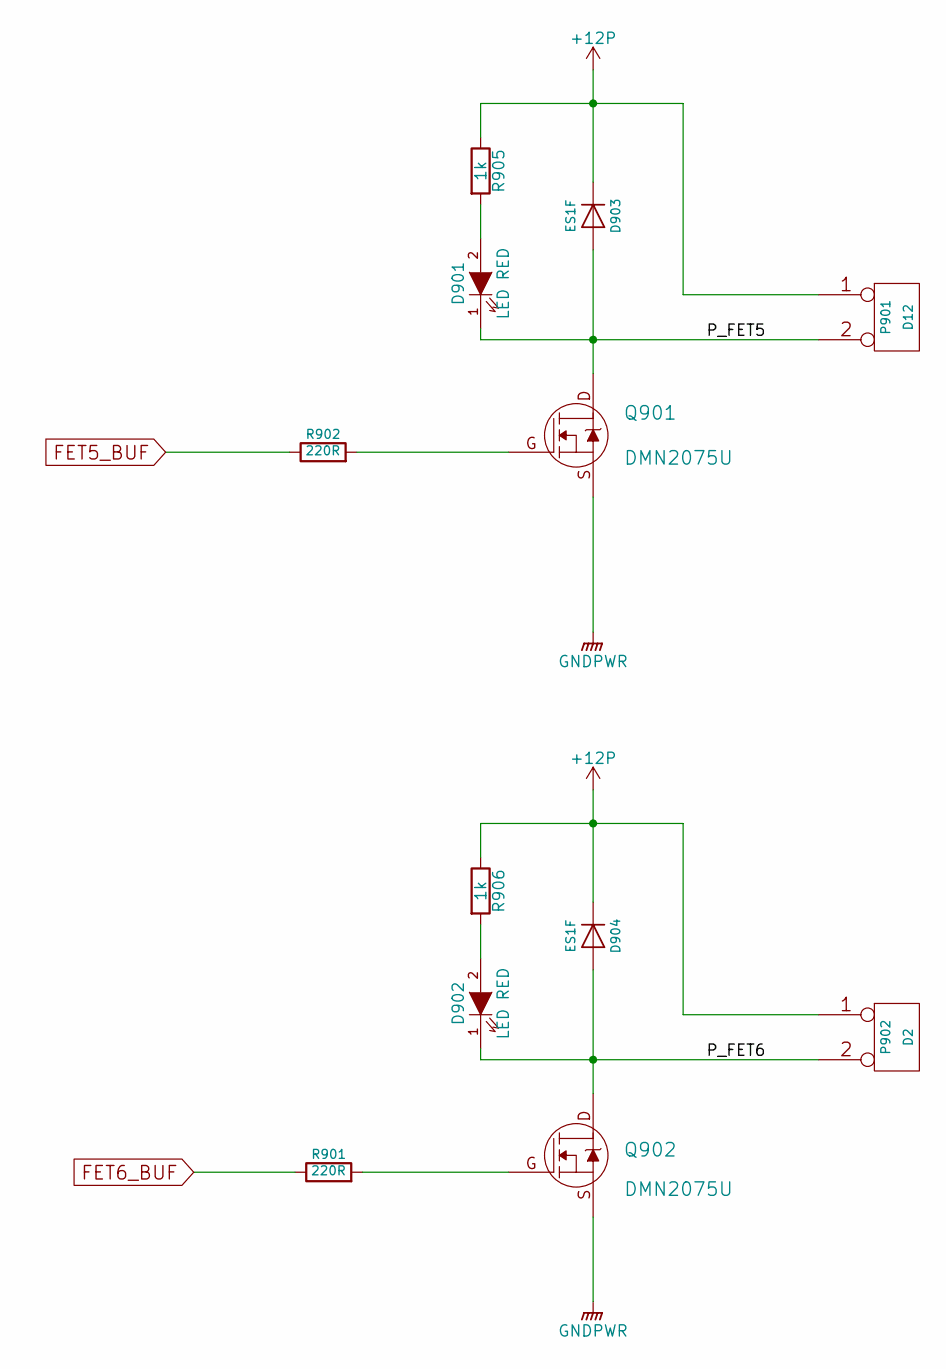
[picture p20: schematic Extra_Mosfets.sch, RAMPS-FD (RAMPS for Arduino Due)]

Parts:
D901, D902: LED RED; LED-0805_RED
D903, D904: ES1F; DO-214AC
P901: D12; CONN_KK_2.54_2W
P902: D2; CONN_KK_2.54_2W
Q901, Q902: DMN2075U; SOT23GDS
R901, R902: 220R; R_0603
R905, R906: 1k; R_0603

Connections:
+12P: D903.1 (K), D904.1 (K), P901.1, P902.1, R905.1, R906.1; also elsewhere on the board
/Extra MOSFETs/P_FET5: D901.1 (K), D903.2 (A), P901.2 (PM), Q901.D
/Extra MOSFETs/P_FET6: D902.1 (K), D904.2 (A), P902.2 (PM), Q902.D
FET5_BUF: R902.1; also elsewhere on the board
FET6_BUF: R901.1; also elsewhere on the board
MOT_GND: Q901.S, Q902.S; also elsewhere on the board
unnamed: D901.2 (A), R905.2
unnamed: D902.2 (A), R906.2
unnamed: Q901.G, R902.2
unnamed: Q902.G, R901.2

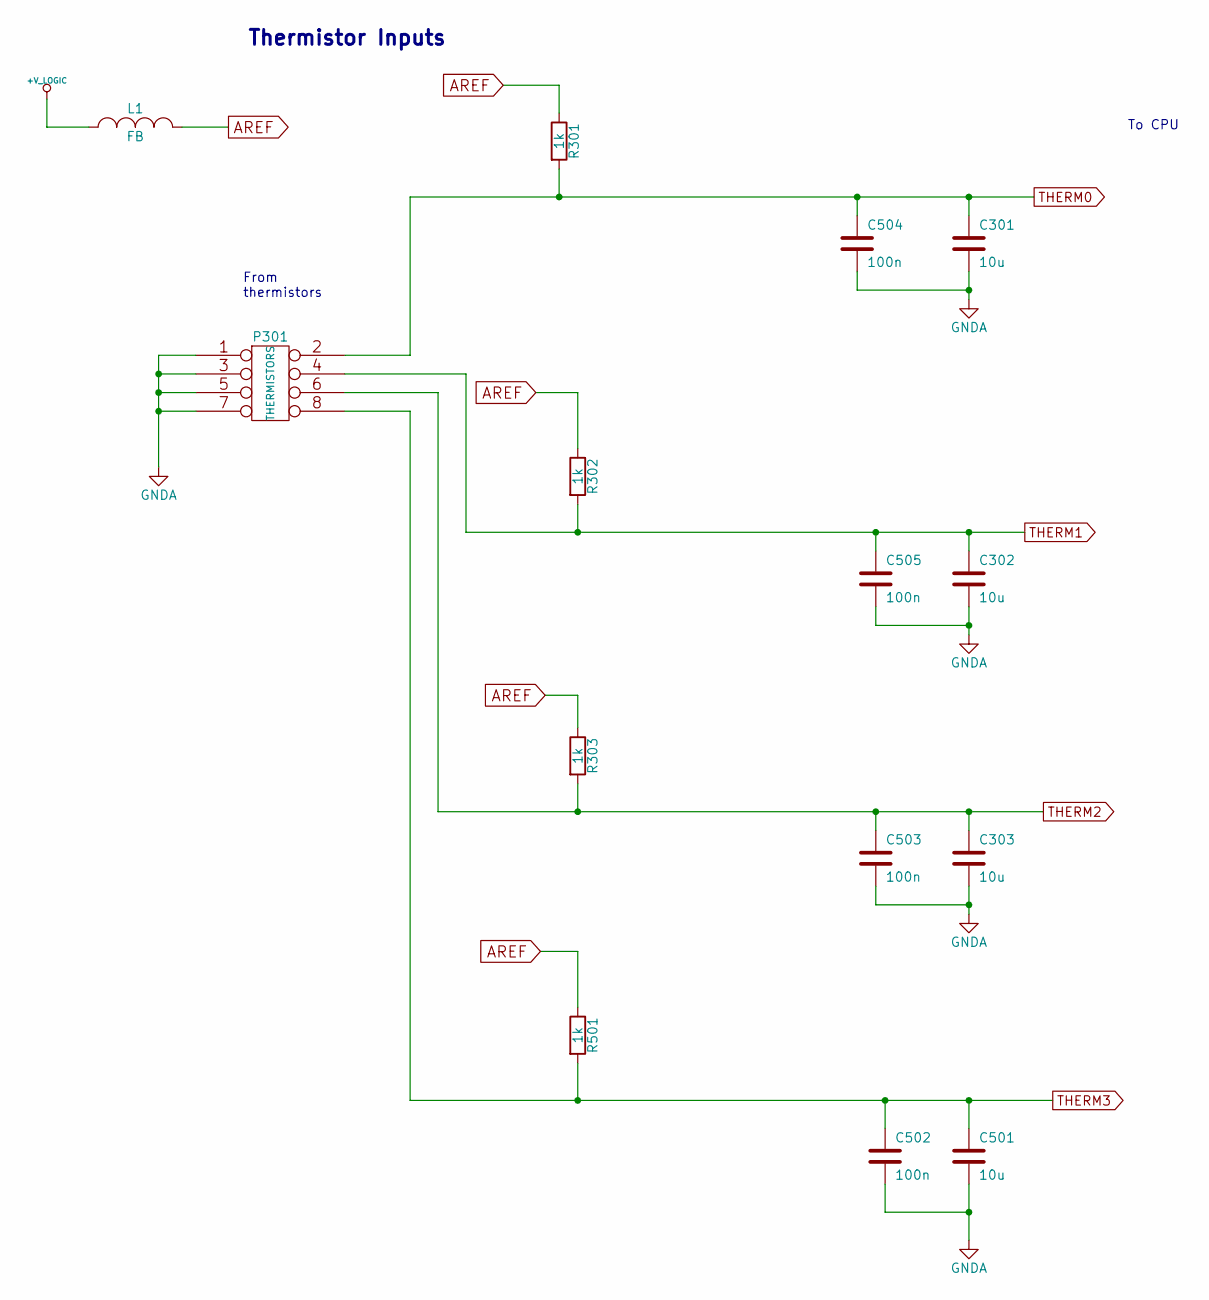
[picture p21: schematic thermistor_inputs.sch, RAMPS-FD (RAMPS for Arduino Due)]

Parts:
C301, C302, C303, C501: 10u; C_0603
C502, C503, C504, C505: 100n; C_0603
L1: FB; R_0603
P301: THERMISTORS; Pin_Header_Straight_2x04_Pitch2.54mm
R301, R302, R303, R501: 1k; R_0603

Connections:
+V_LOGIC: L1.1; also elsewhere on the board
AREF: L1.2, R301.1, R302.1, R303.1, R501.1
GNDA: C301.2, C302.2, C303.2, C501.2, C502.2, C503.2, C504.2, C505.2, P301.1, P301.3, P301.5, P301.7; also elsewhere on the board
THERM0: C301.1, C504.1, P301.2, R301.2; also elsewhere on the board
THERM1: C302.1, C505.1, P301.4, R302.2; also elsewhere on the board
THERM2: C303.1, C503.1, P301.6, R303.2; also elsewhere on the board
THERM3: C501.1, C502.1, P301.8, R501.2; also elsewhere on the board

Notes on the sheet:
To CPU
From thermistors
Thermistor Inputs

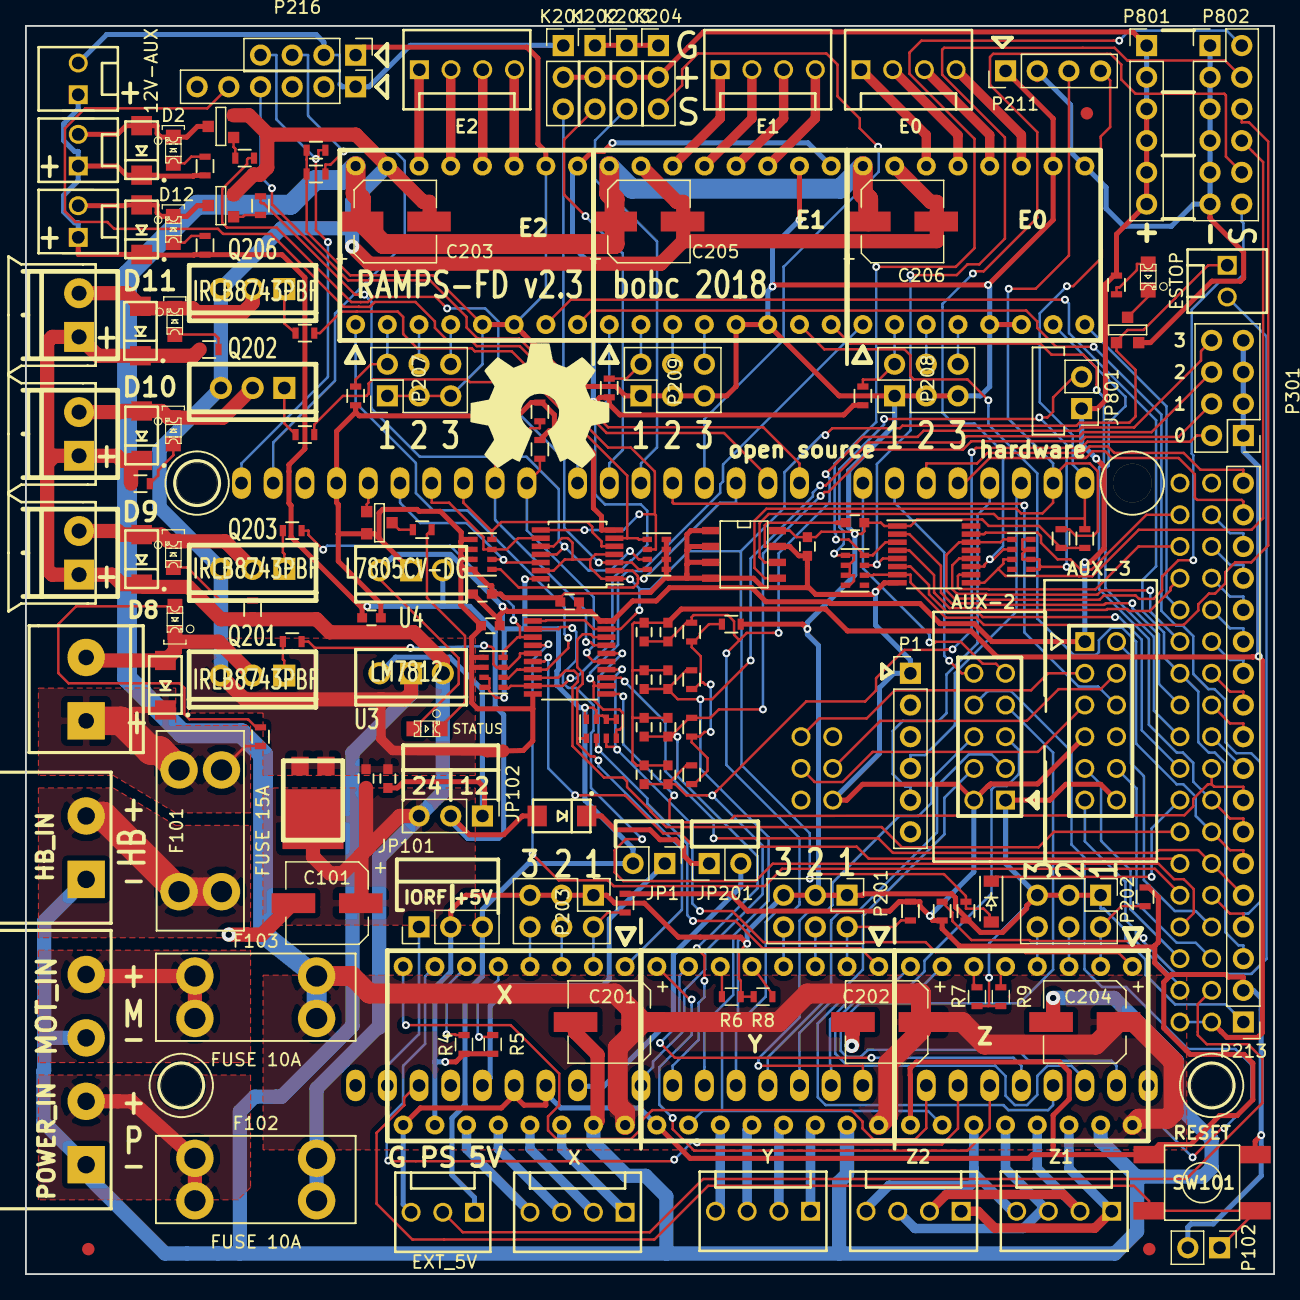
[picture p22: board RAMPS-FD.kicad_pcb from above]

Board: 2 copper layers, 100.0 x 100.0 mm, 159 parts (0 on the bottom side), 185 nets.
