bobc/RAMPS-FD/(commit log)

2016-07-17 Initial v2.2
    [Extra_Mosfets.sch, Power.sch, RAMPS-FD.kicad_pcb, RAMPS-FD.sch, con_inputs.sch, con_misc.sch, con_outputs.sch, e-stop.sch]
2018-06-01 Changed fuse holders to Keystone 3568; specificy HCT instead of ACT logic
    [Extra_Mosfets.sch, Power.sch, RAMPS-FD.kicad_pcb, RAMPS-FD.sch, con_inputs.sch, con_misc.sch, con_outputs.sch, e-stop.sch]
2018-06-01 Add footprint libraries
2018-06-01 More up to date BOM for 2.2
    [RAMPS-FD_bom_Itead.xlsx]
2018-06-02 Fix 3d view; remove faulty ADC protection
    [Extra_Mosfets.sch, Power.sch, RAMPS-FD.kicad_pcb, RAMPS-FD.sch, con_inputs.sch, con_misc.sch, con_outputs.sch, e-stop.sch]
